afcaff/opamp-amp/docs/HandCalcs.pdf

Adrian Franco Preamp calculations: Gain stage
Gain:
GG = 1 +

RRFF
RRGG
1 +

100kk
10kk = 11
Gain(dB):
GG = 20 log 11
20 log 11 = 20.8 dddd
Frequency of High pass corner (gain stage): ff(HHHH) = 1
2ππ ππ
1
2ππ × 10kk × 1nnnn = 1.59 HHHH Frequency of Low pass corner (gain stage): ff(HHHH) = 1
2ππ ππ
1
2ππ × 10kk × 47μμ

= 0.338 HHHH
Active Baxandall circuit
Bass side resistors ( Rpot = 100k)
GG = RR2
RR1
(100kk + RR)
RR = 4
4RR = 100kk + RR
RR = 100kk
3
RR ≈ 33kk

Capacitor values for low corner (bass), target 50 Hz: ff = 1
2ππ ππ
= 1
2ππ
= 1
2ππ × 33kk × 50
= 31.8nnnn → 33nnnn
Bass Gain range:
GG = 100kk + 33kk
33kk
GG ≈ 4
GG = 20 log(4) = 12dddd
GG = 33kk
(100kk + 33kk)
GG = 0.248
GG = 20 log 0.248
GG = −12dddd
GG = ±12dddd
Treble side resistor:
1 +

33kk
RR = 4
3 =

33kk
RR
RR = 11kk
Capacitor (target 3k Hz)
= 1
2ππ × 11kk × 3kk
= 4.82nnnn → 4.7nnnn

Treble gain range:
GG = 1 +

33kk
11kk = 4
GG = 20 log 4 = 12dddd

GG =

1
33kk
1

33kk + 1
11kk
GG ≈ 0.25
GG = 2 log 0.25 = −12dddd
GG = ±12dddd
