afcaff/opamp-amp/FullCircuitsim/ac-flat.pdf

(A) FLATAC.dat

Frequency

10Hz | 100Hz | 1.0KHz | 10KHz | 100KHz
DB(V(U2:5)/V(V1:+))

0

5

10

15

20

25

30
