afcaff/opamp-amp/media/complete.jpg

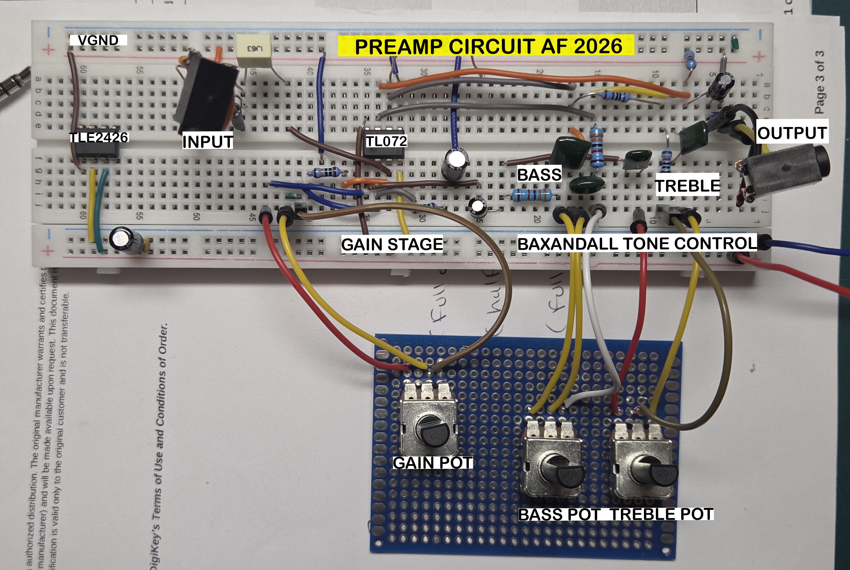
media/complete.jpg
