afcaff/opamp-amp/media/gbr.png

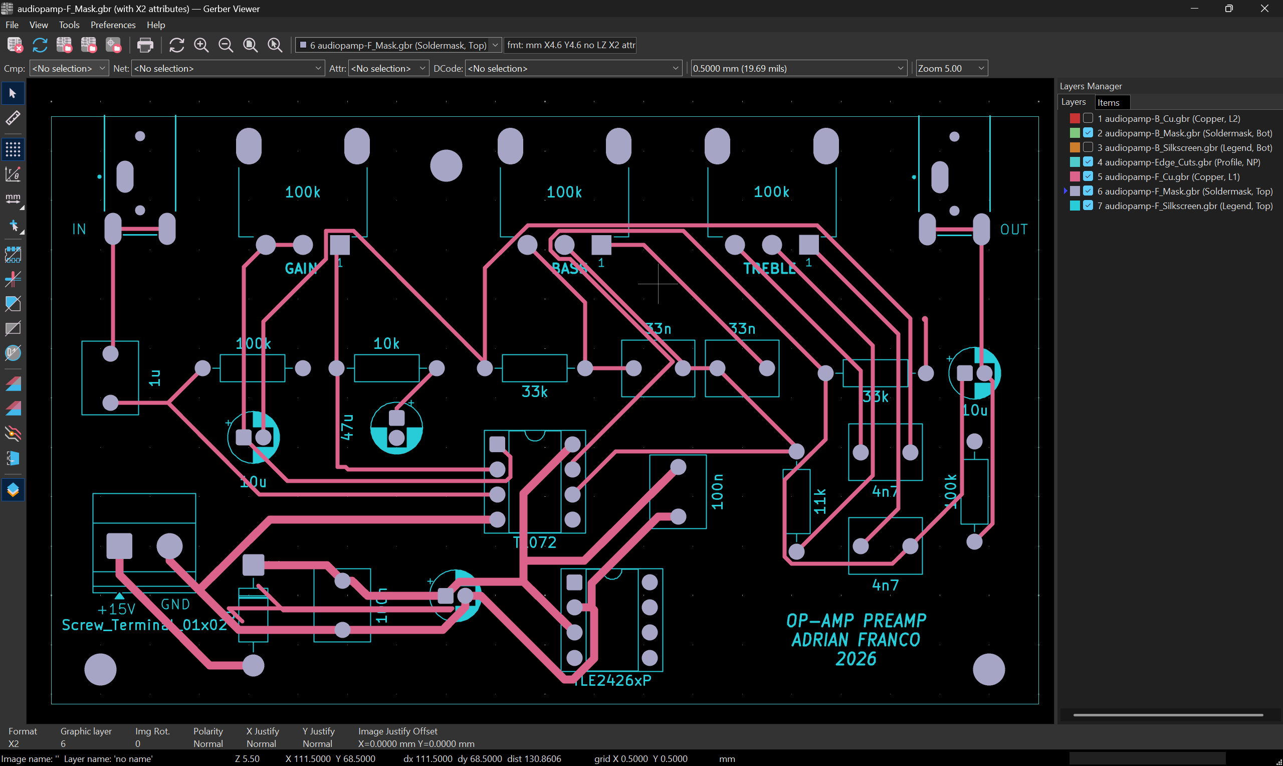
media/gbr.png
