afcaff/opamp-amp/media/scope/dso_01_01_01_24_35.bmp

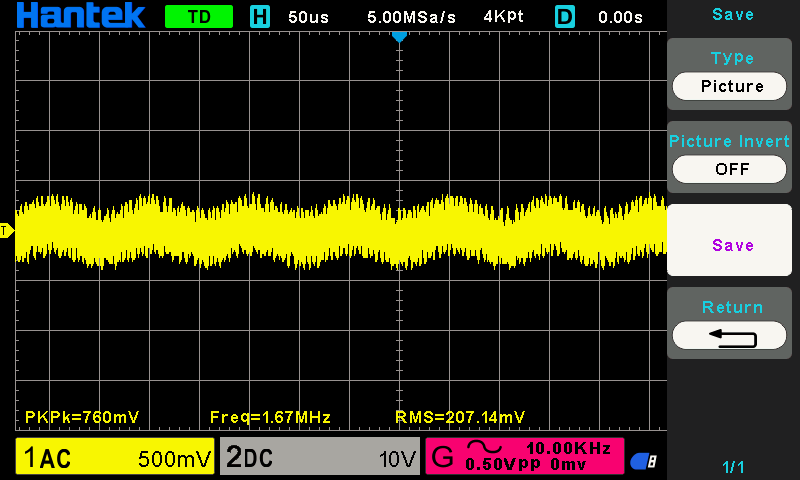
media/scope/dso_01_01_01_24_35.bmp
