afcaff/opamp-amp/media/scope/gain.bmp

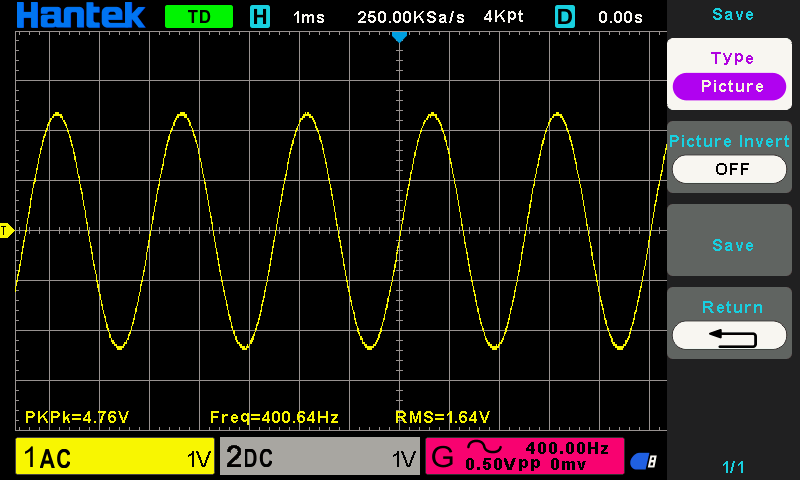
media/scope/gain.bmp
