afcaff/opamp-amp/media/scope/trebboost.bmp

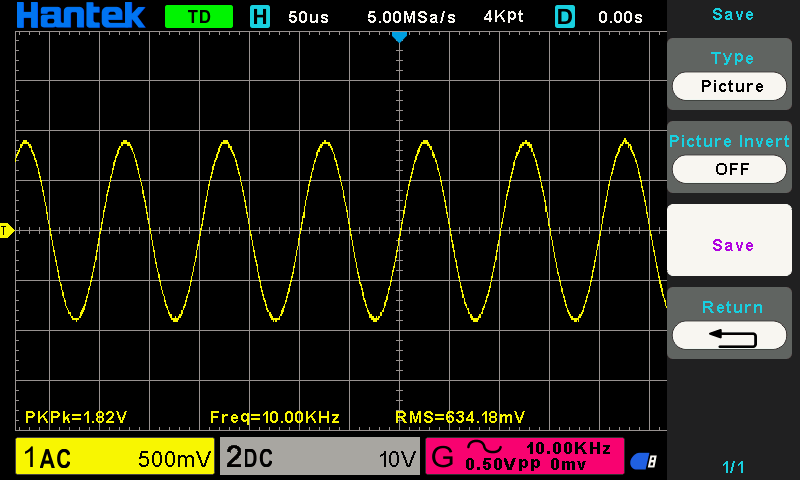
media/scope/trebboost.bmp
