afcaff/opamp-amp/media/scope/trebscratch.bmp

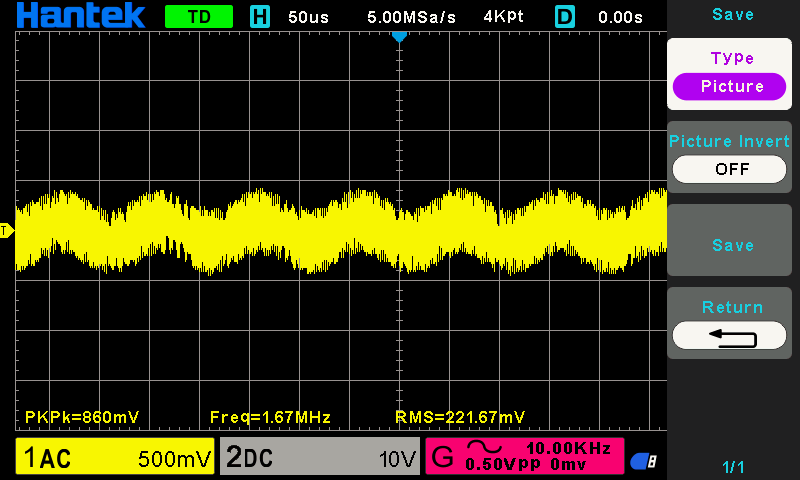
media/scope/trebscratch.bmp
