afcaff/opamp-amp/sim/baxandall/activebaxandall.png

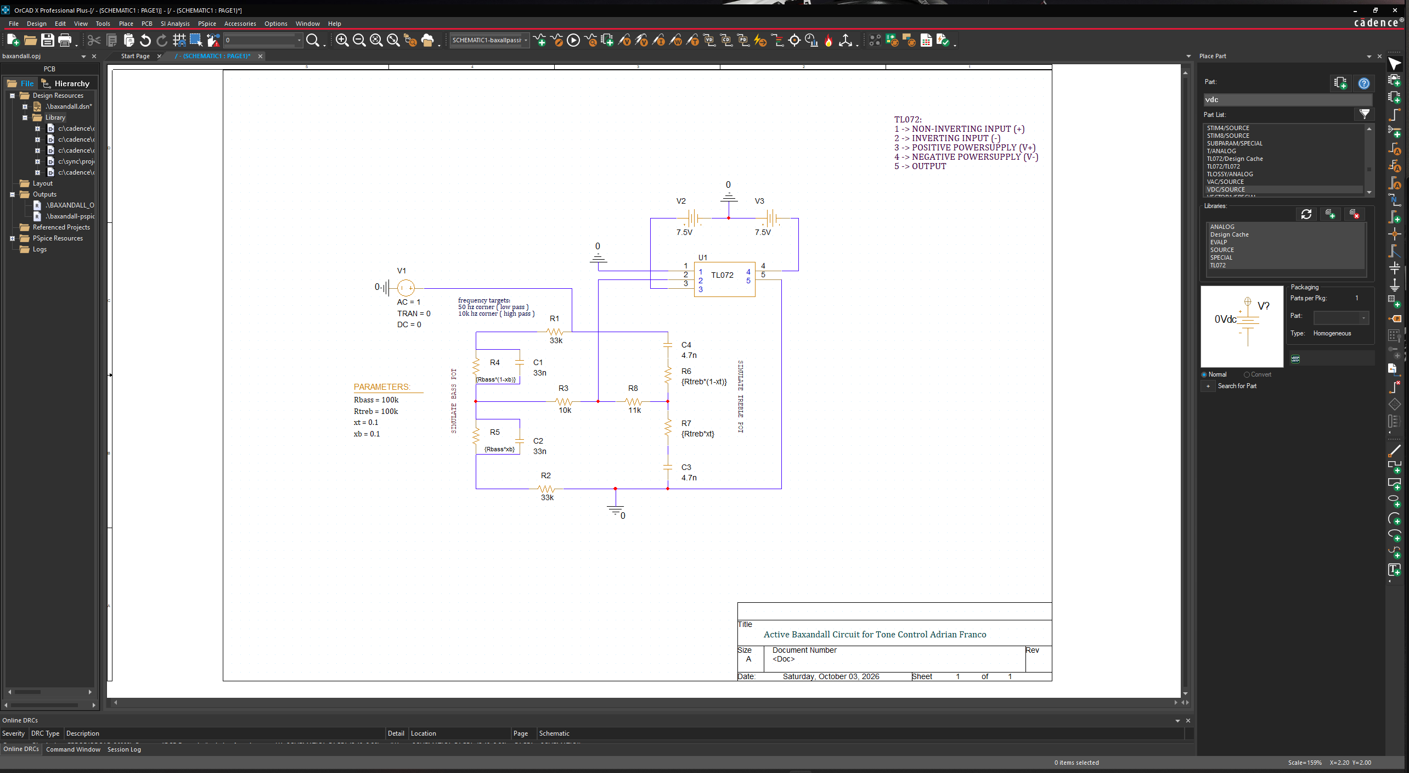
sim/baxandall/activebaxandall.png
