afcaff/opamp-amp/sim/baxandall/ActiveBaxandall/0dBSymmetry.png

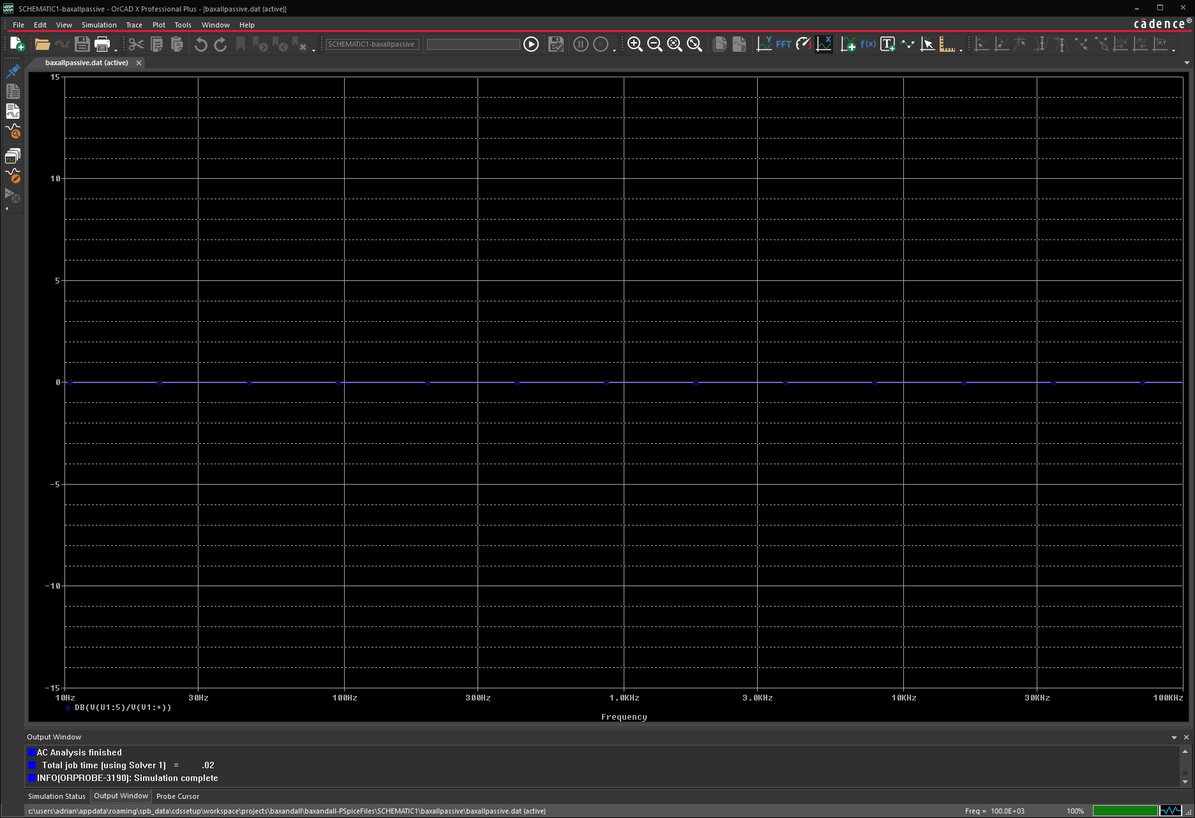
sim/baxandall/ActiveBaxandall/0dBSymmetry.png
