afcaff/opamp-amp/sim/baxandall/ActiveBaxandall/12dBRange-Treble.png

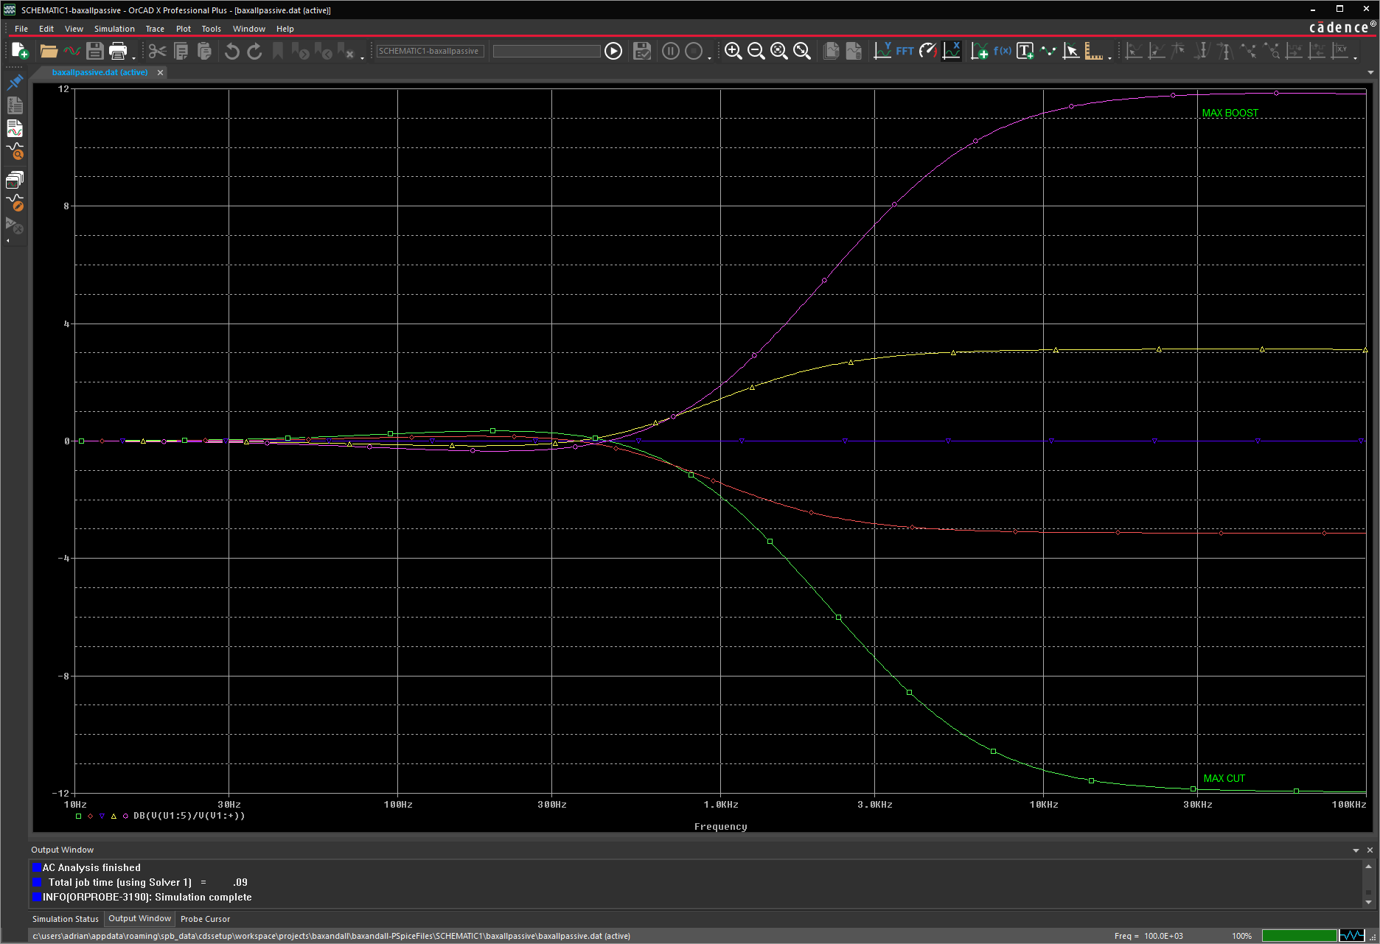
sim/baxandall/ActiveBaxandall/12dBRange-Treble.png
