afcaff/opamp-amp/sim/baxandall/activeBaxandallCricuitreference.png

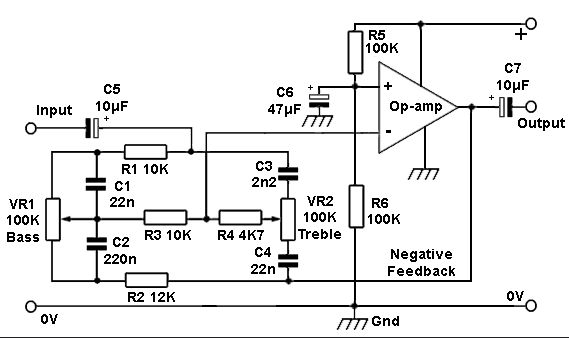
sim/baxandall/activeBaxandallCricuitreference.png
