afcaff/opamp-amp/sim/baxandall/baxandallresponse.jpg

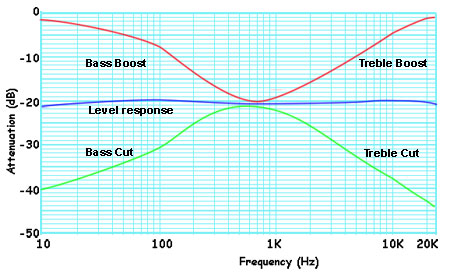
sim/baxandall/baxandallresponse.jpg
