afcaff/opamp-amp/sim/baxandall/passiveBxdall/bxdall.png

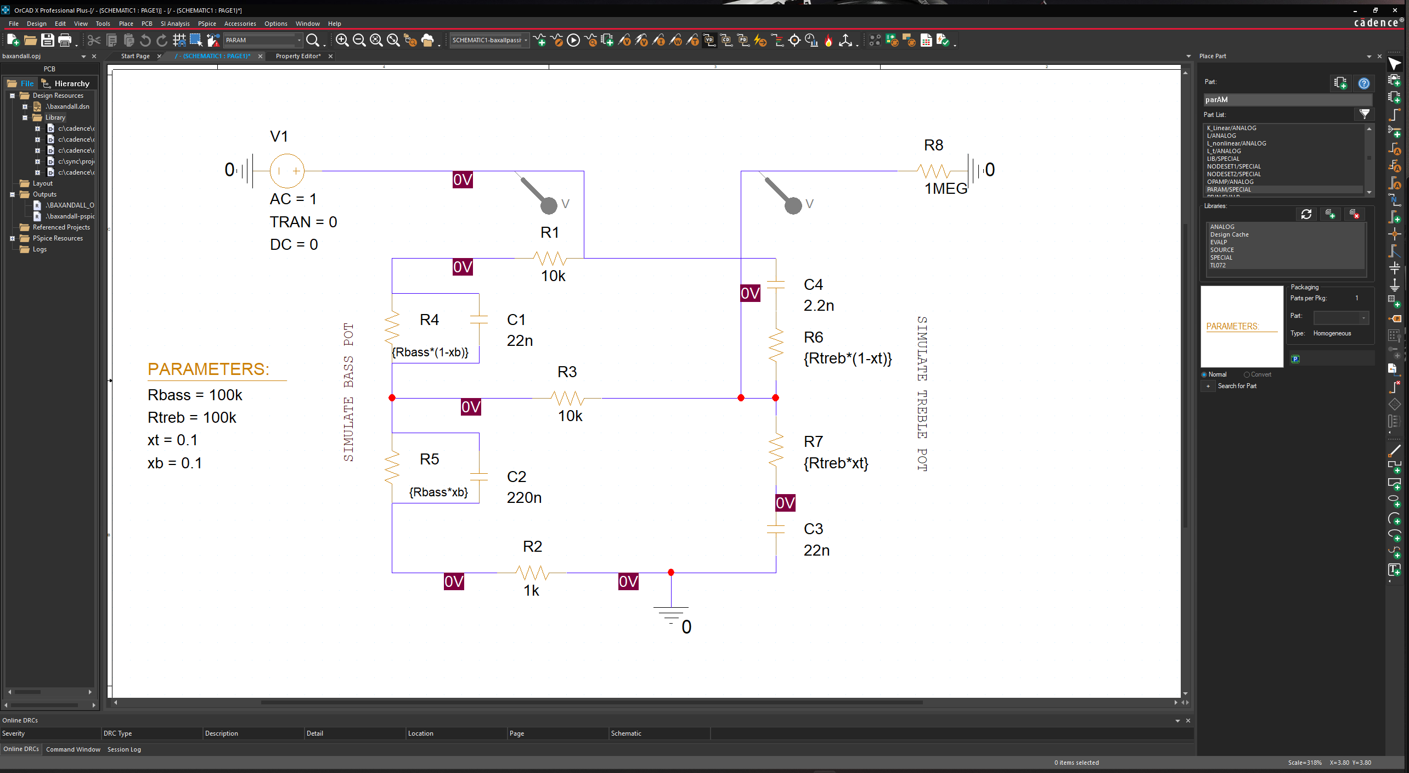
sim/baxandall/passiveBxdall/bxdall.png
