afcaff/opamp-amp/sim/baxandall/passiveBxdall/TREBmaxboostmaxcut.png

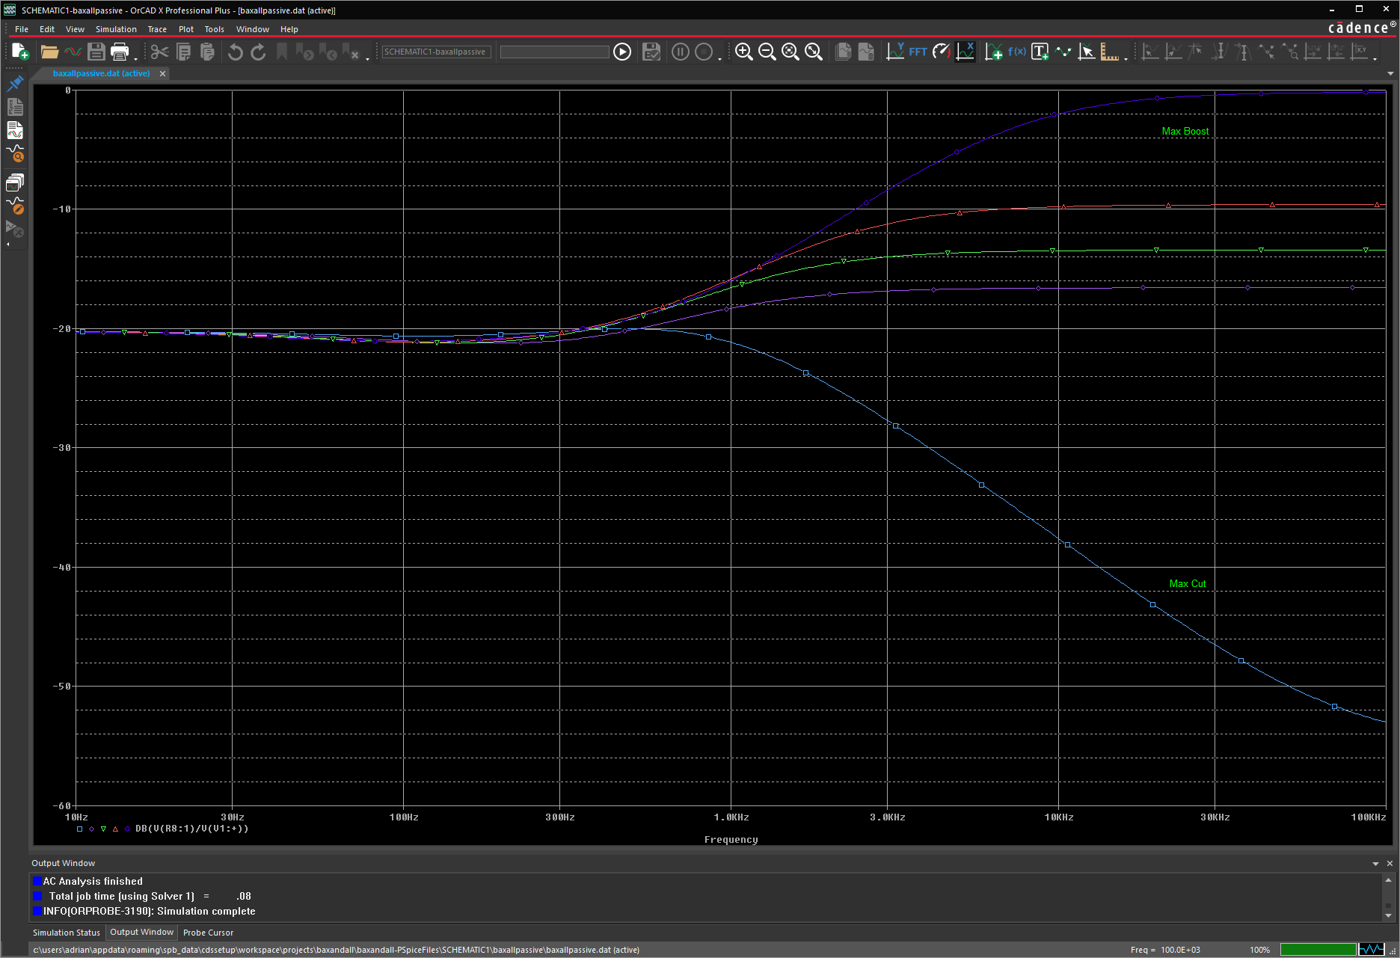
sim/baxandall/passiveBxdall/TREBmaxboostmaxcut.png
