afcaff/opamp-amp/sim/GainStage/fftHarmonics.png

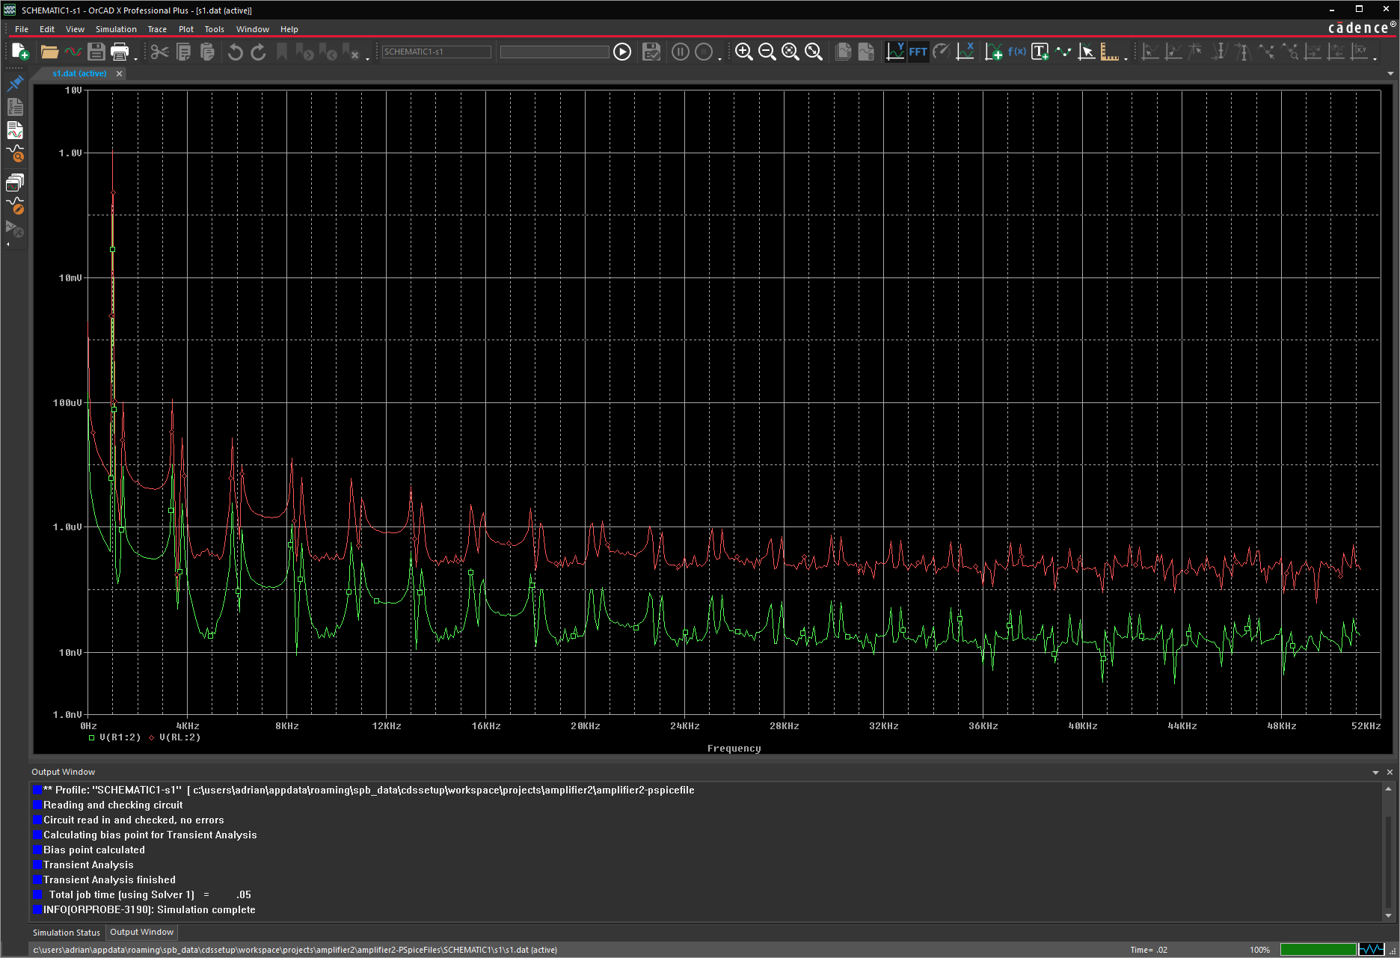
sim/GainStage/fftHarmonics.png
