afcaff/opamp-amp/sim/GainStage/GainCircuit.png

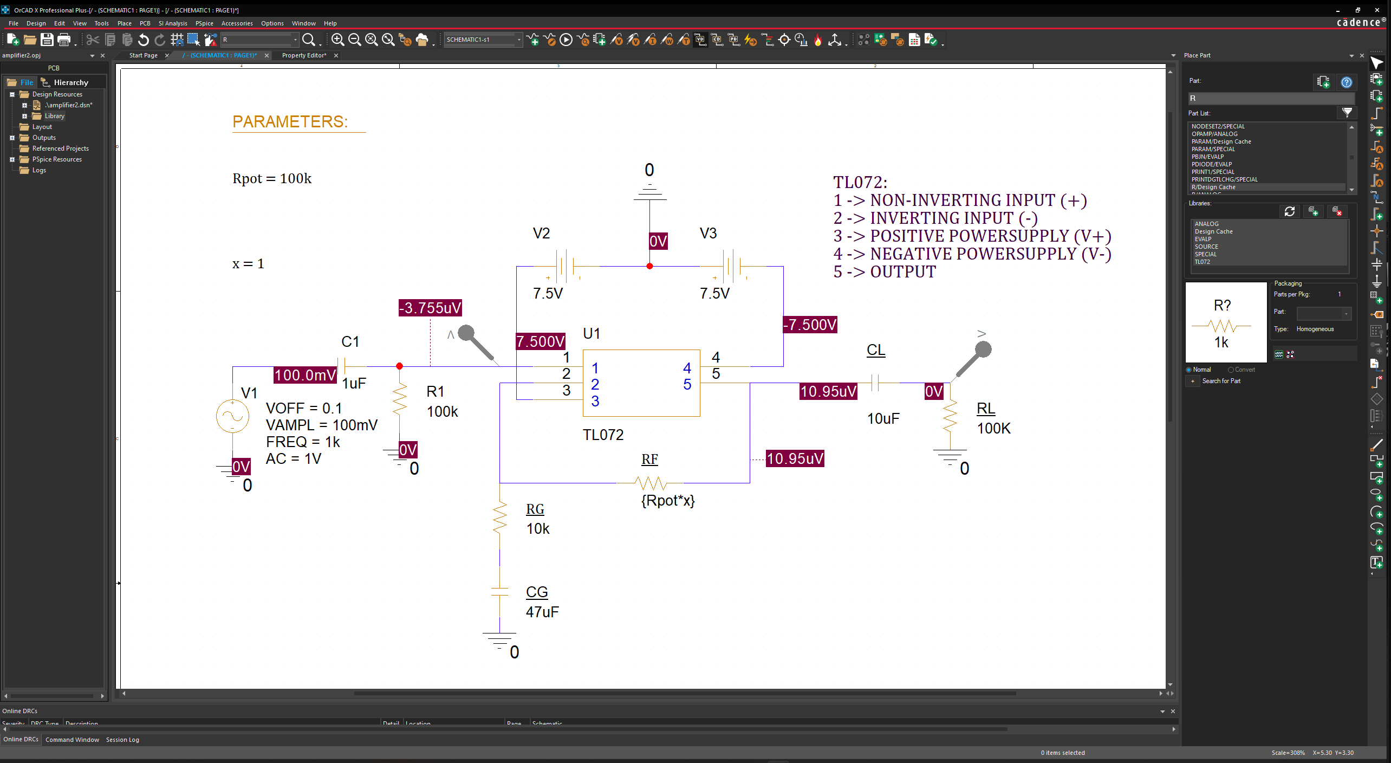
sim/GainStage/GainCircuit.png
