afcaff/opamp-amp/sim/GainStage/SweepdB.png

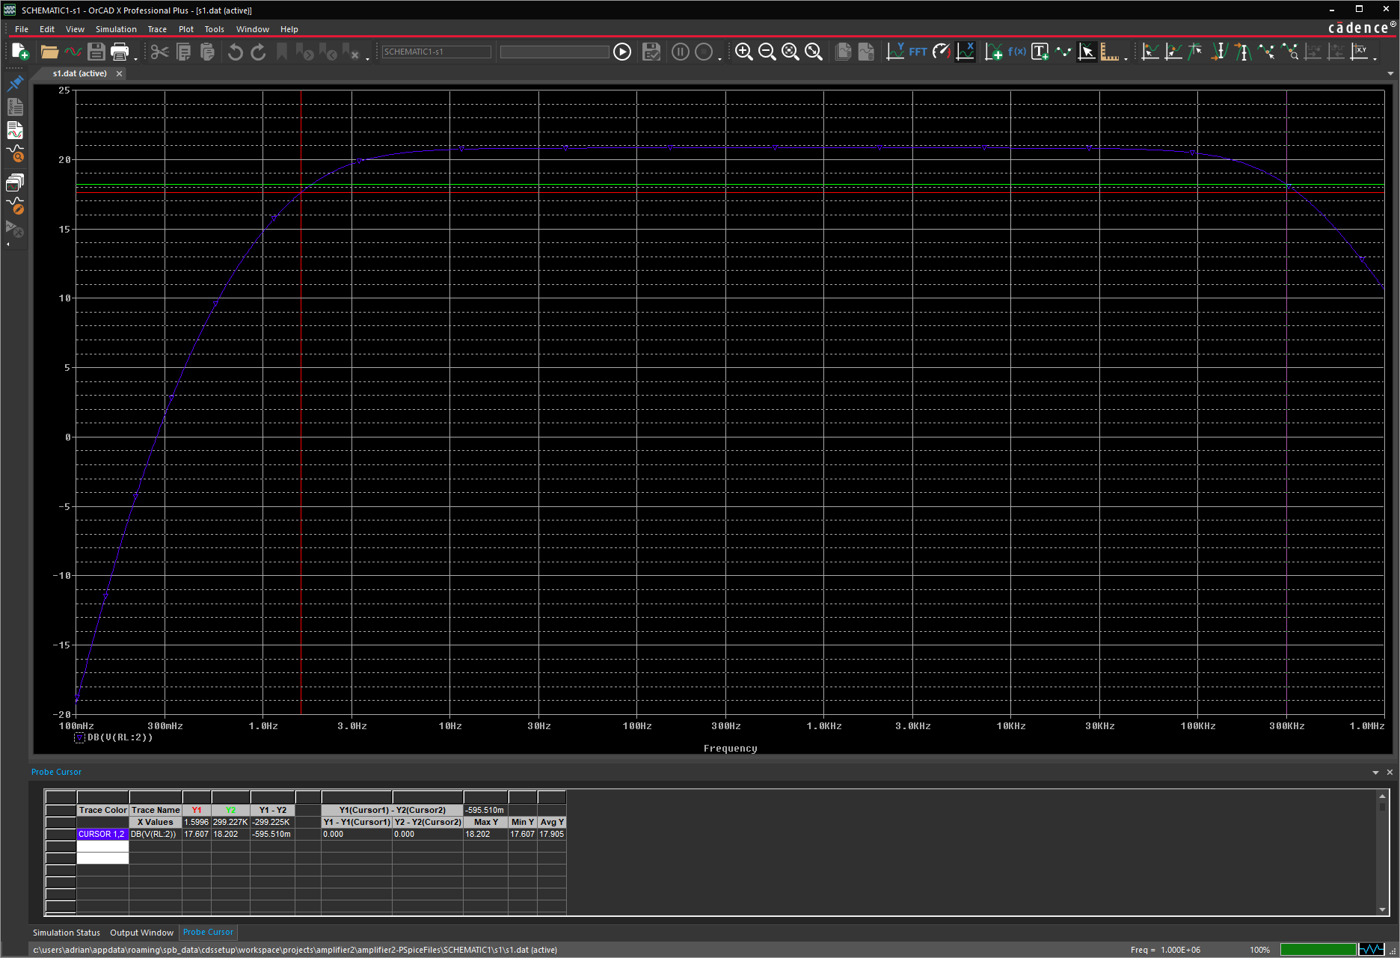
sim/GainStage/SweepdB.png
