afcaff/opamp-amp/sim/non-inverting/circuit.png

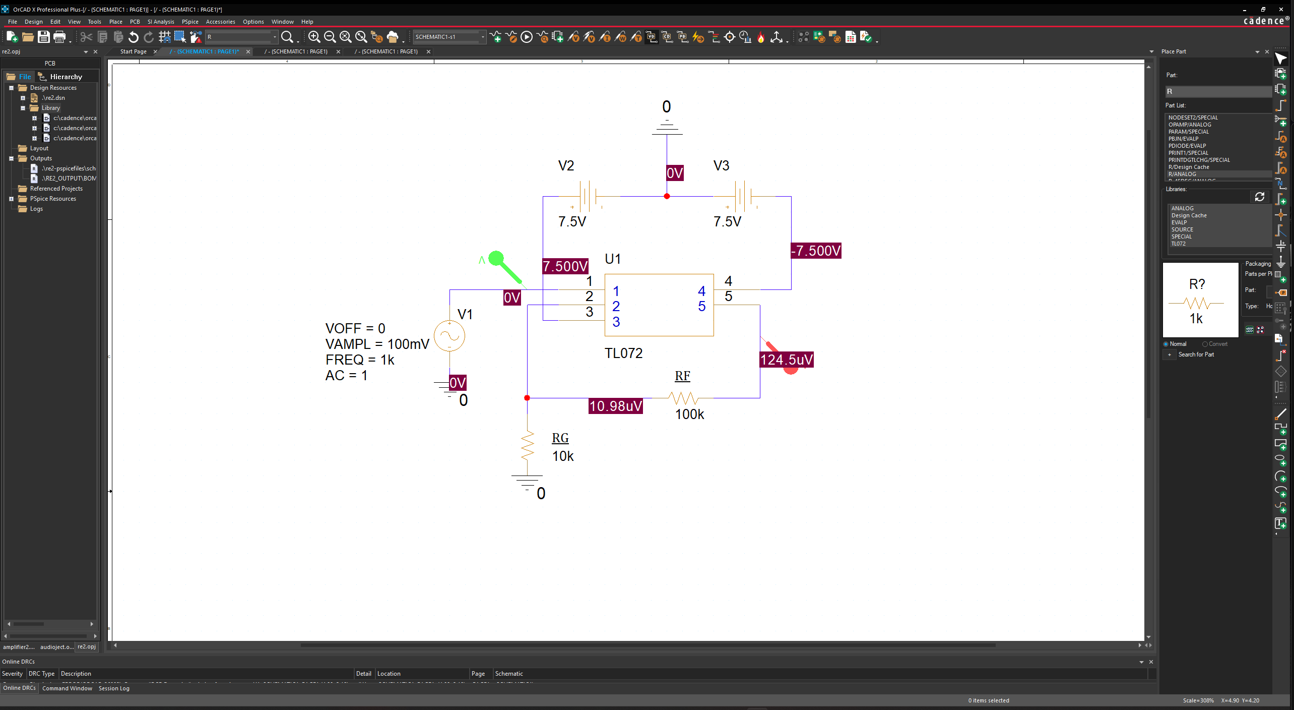
sim/non-inverting/circuit.png
