afcaff/opamp-amp/sim/non-inverting/clipping1V.png

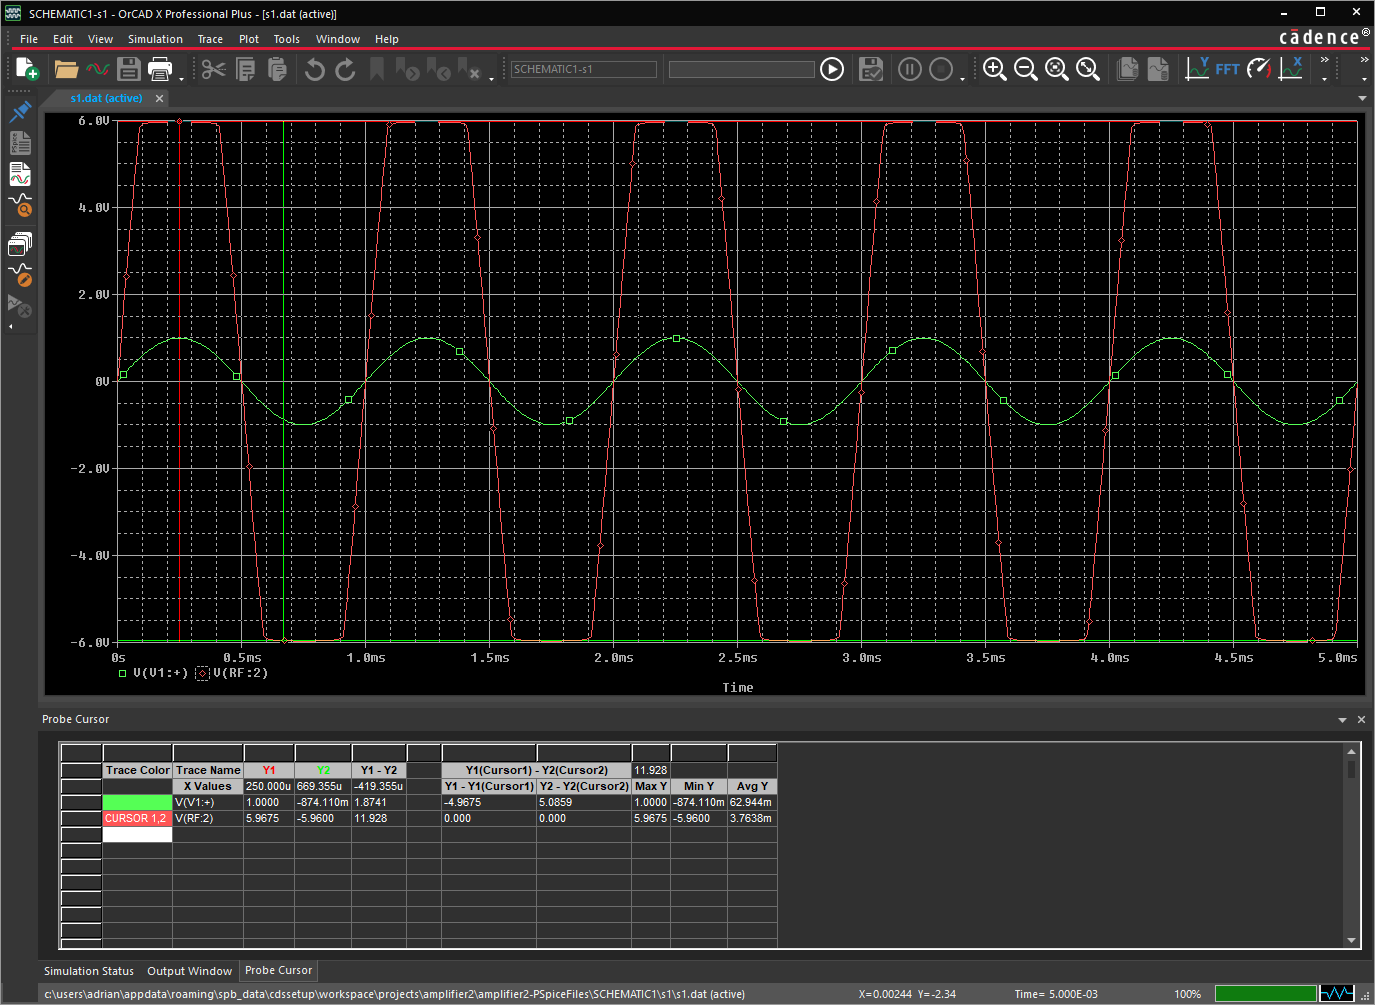
sim/non-inverting/clipping1V.png
