afcaff/opamp-amp/sim/non-inverting/clipping10V.png

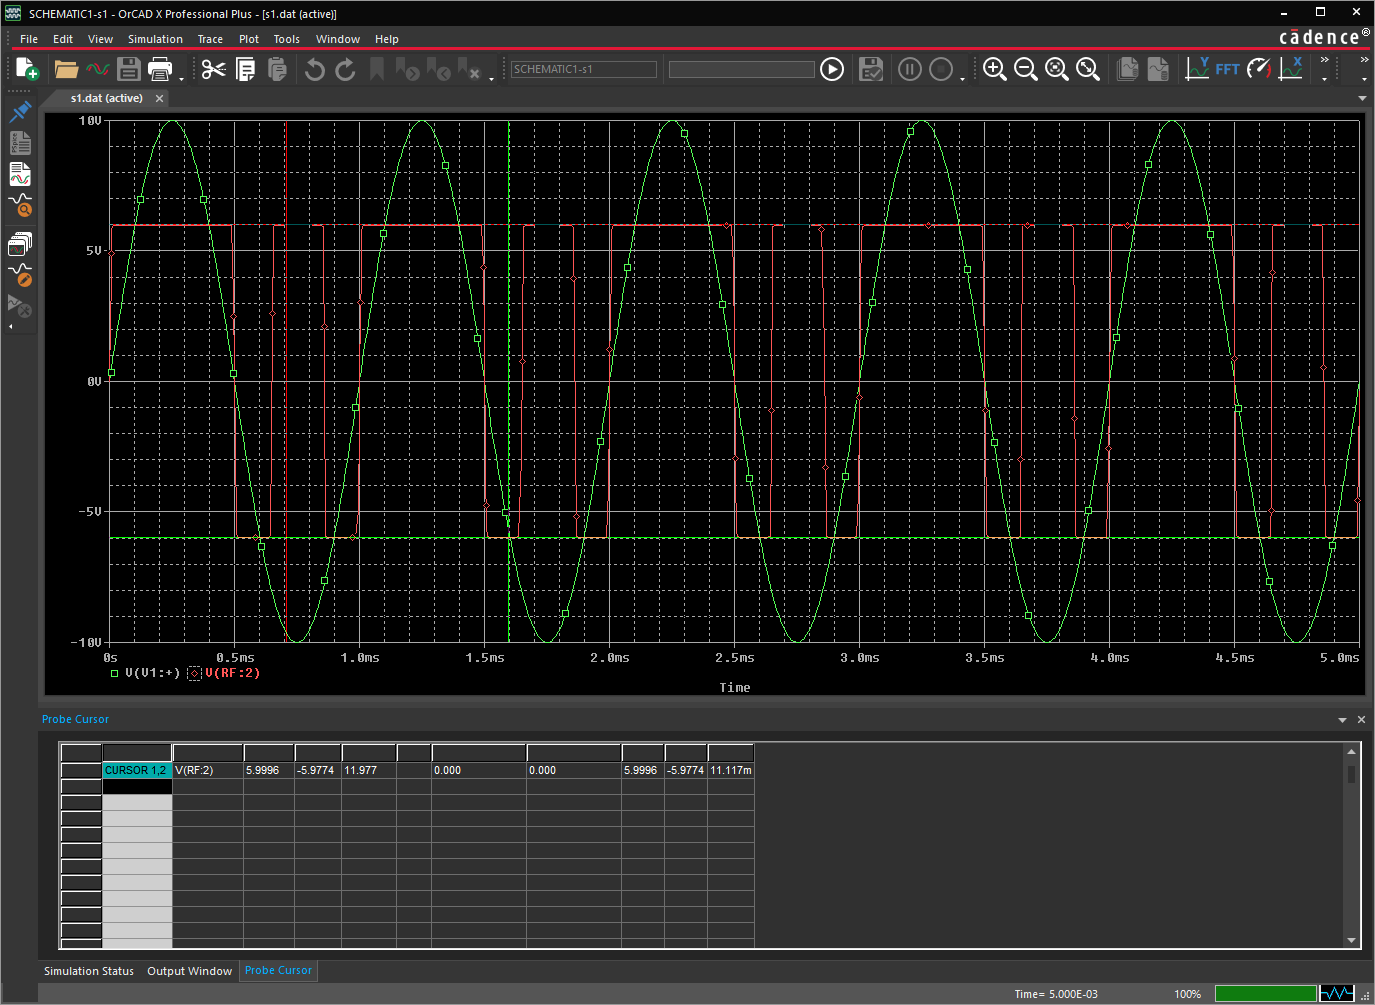
sim/non-inverting/clipping10V.png
