afcaff/opamp-amp/sim/non-inverting/transient.png

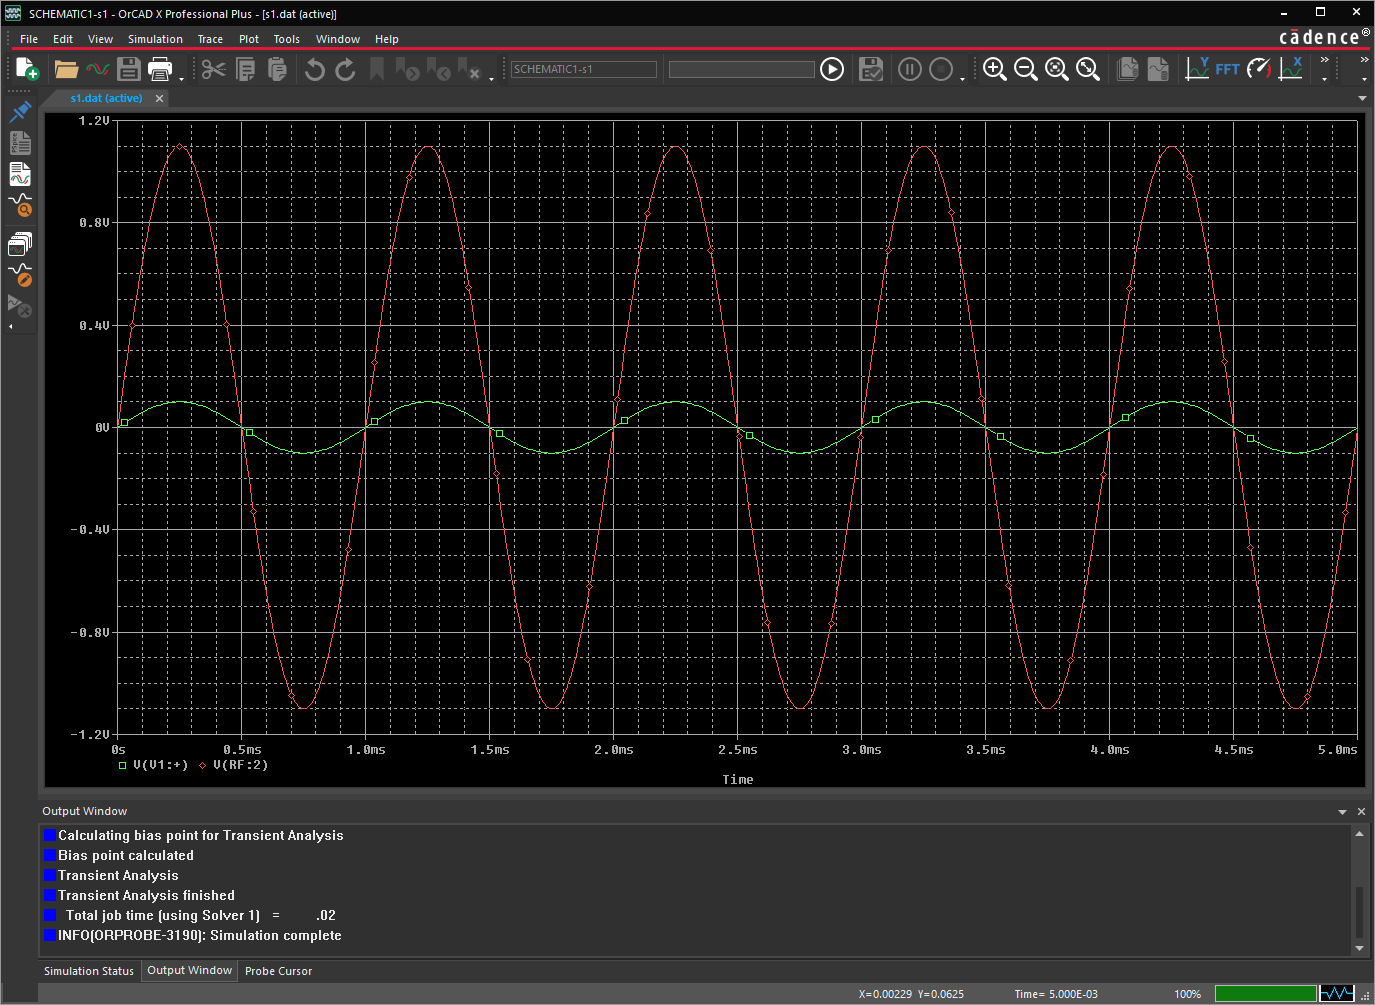
sim/non-inverting/transient.png
