afcaff/opamp-amp/sim/non-invertingWpot/circuit.png

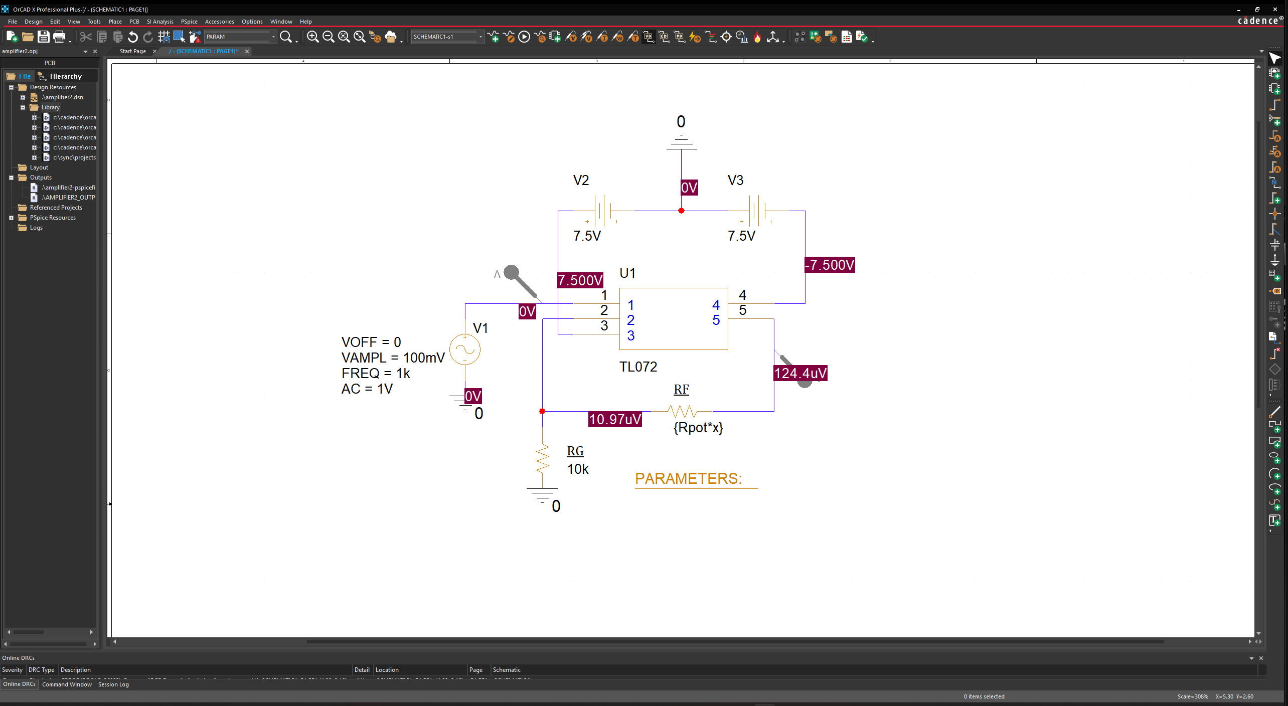
sim/non-invertingWpot/circuit.png
