afcaff/opamp-amp/sim/non-invertingWpot/SweepdB.png

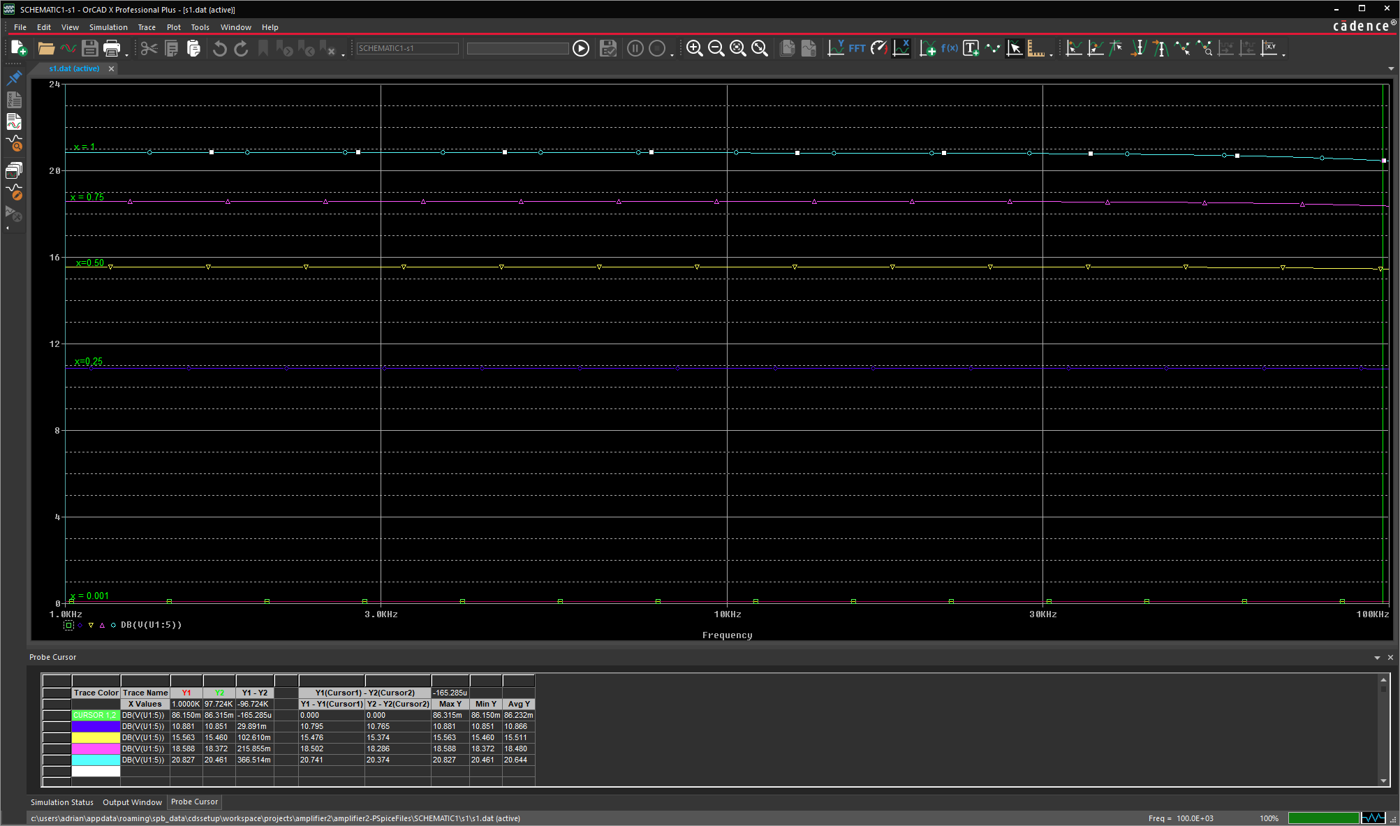
sim/non-invertingWpot/SweepdB.png
