afcaff/opamp-amp/media/pcbassemble.jpg

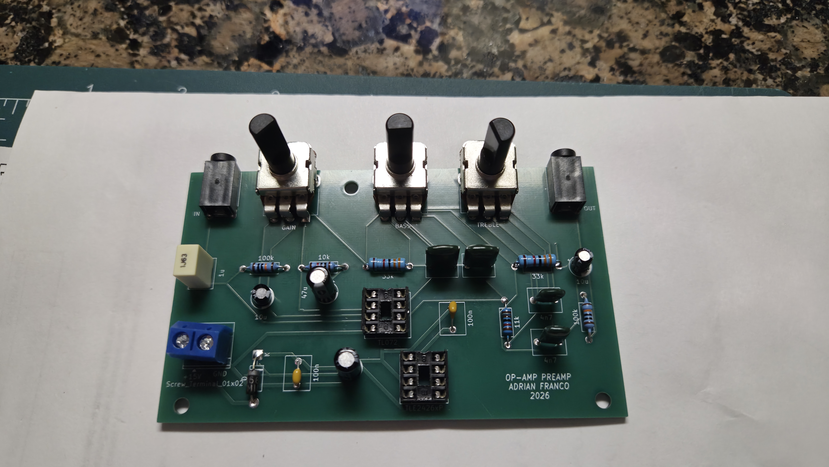
media/pcbassemble.jpg
