afcaff/opamp-amp/measure/scope/bassboost.bmp

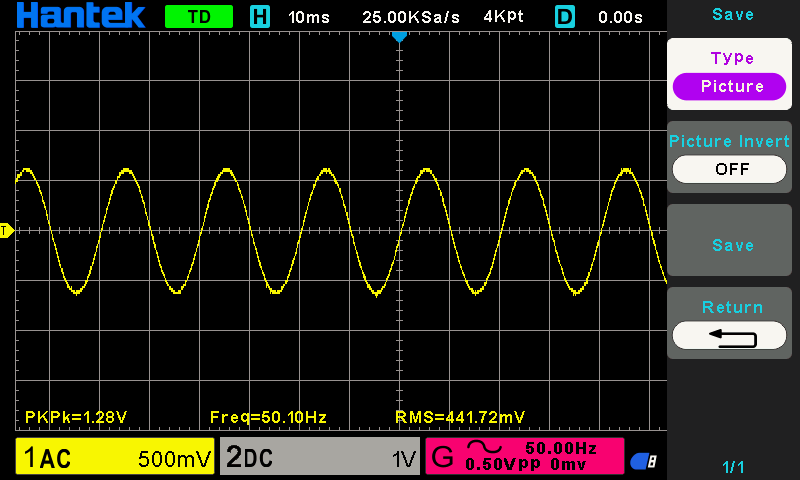
measure/scope/bassboost.bmp
