afcaff/opamp-amp/measure/scope/basscut.bmp

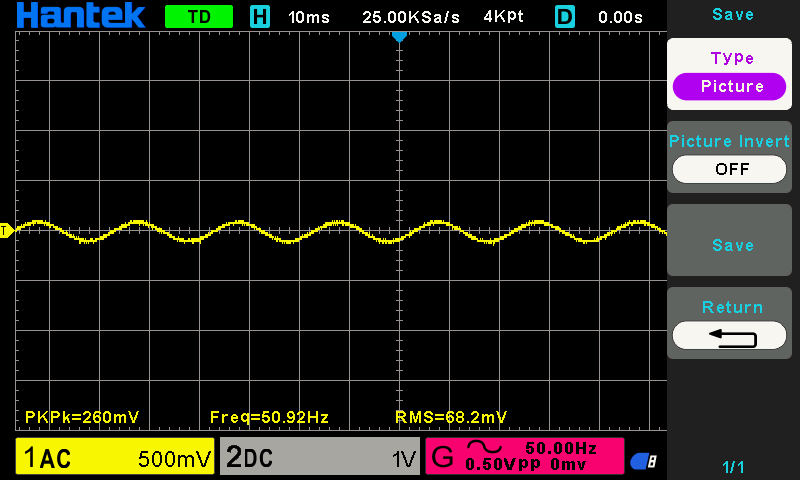
measure/scope/basscut.bmp
