afcaff/opamp-amp/measure/scope/basscut.jpg

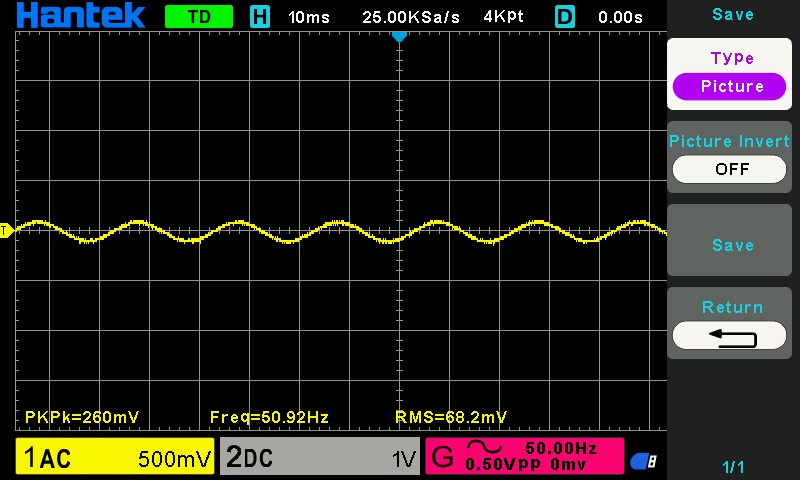
measure/scope/basscut.jpg
