afcaff/opamp-amp/measure/scope/bassmid.jpg

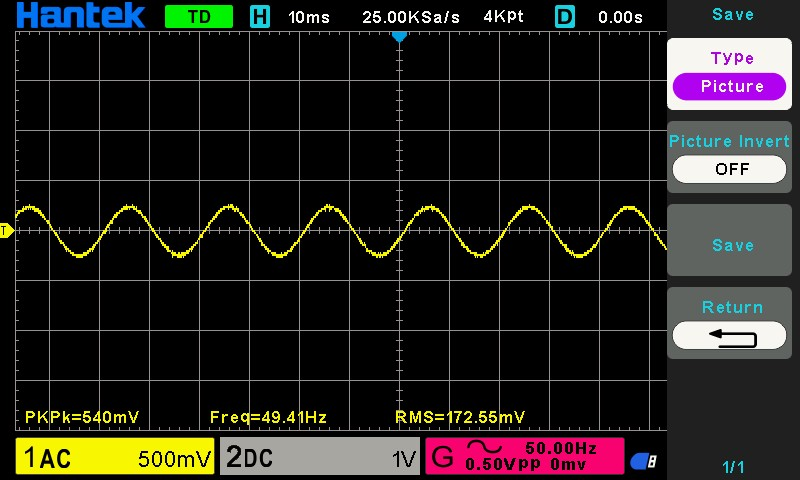
measure/scope/bassmid.jpg
