afcaff/opamp-amp/measure/scope/trebbcutb4break.bmp

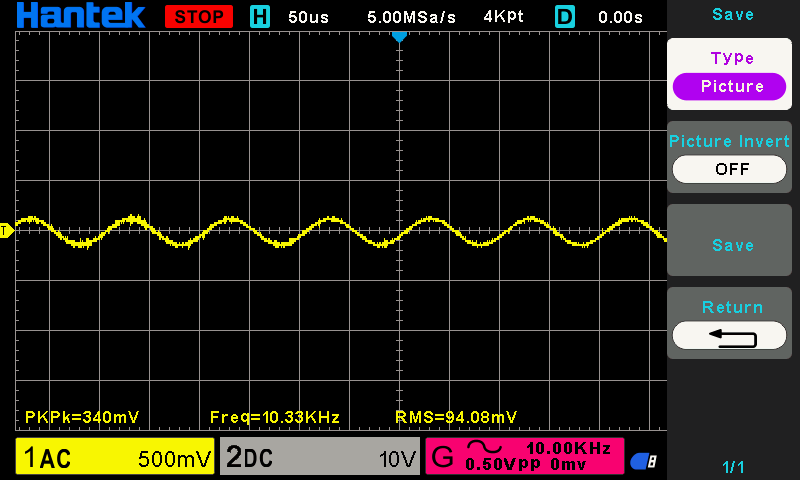
measure/scope/trebbcutb4break.bmp
