afcaff/opamp-amp/measure/scope/trebmid.bmp

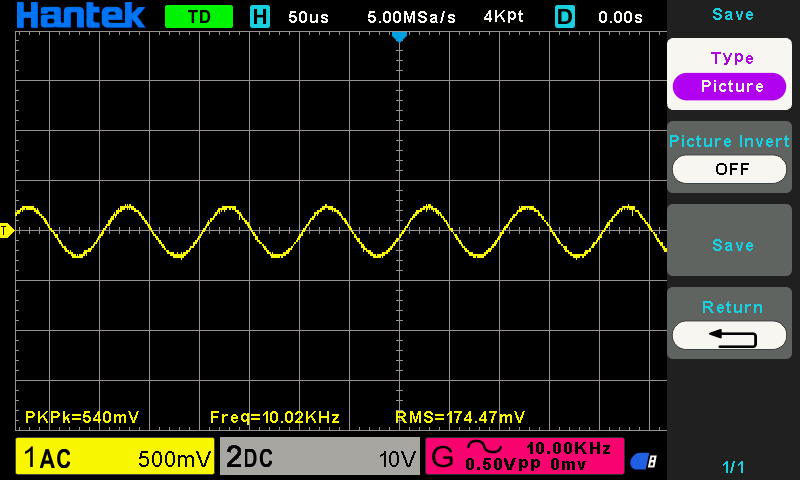
measure/scope/trebmid.bmp
