afcaff/opamp-amp/measure/scope/trebmid.jpg

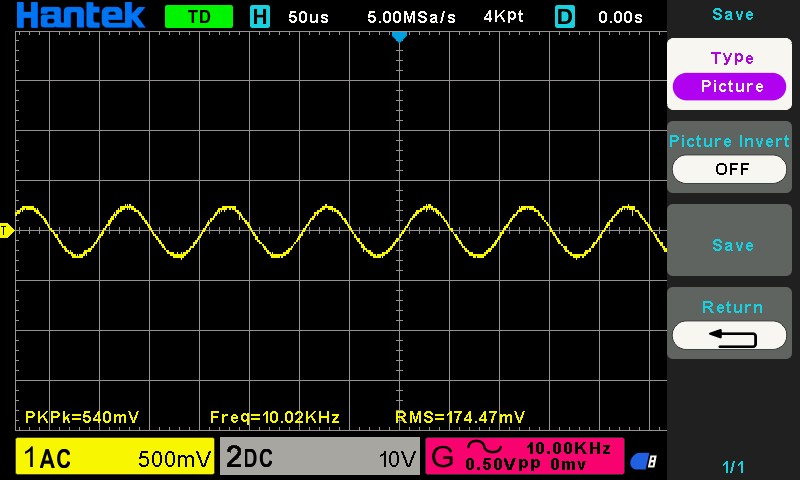
measure/scope/trebmid.jpg
