afcaff/opamp-amp/sim/buff_test/capture.png

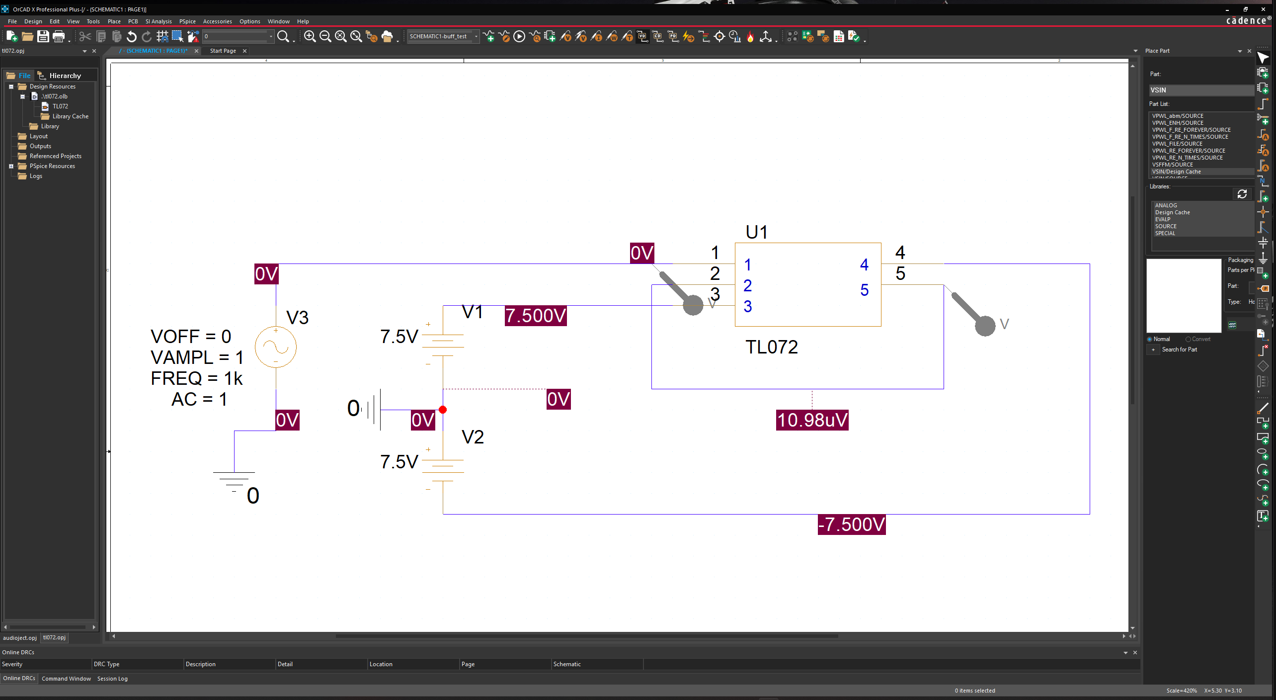
sim/buff_test/capture.png
