afcaff/opamp-amp/sim/buff_test/pspice.png

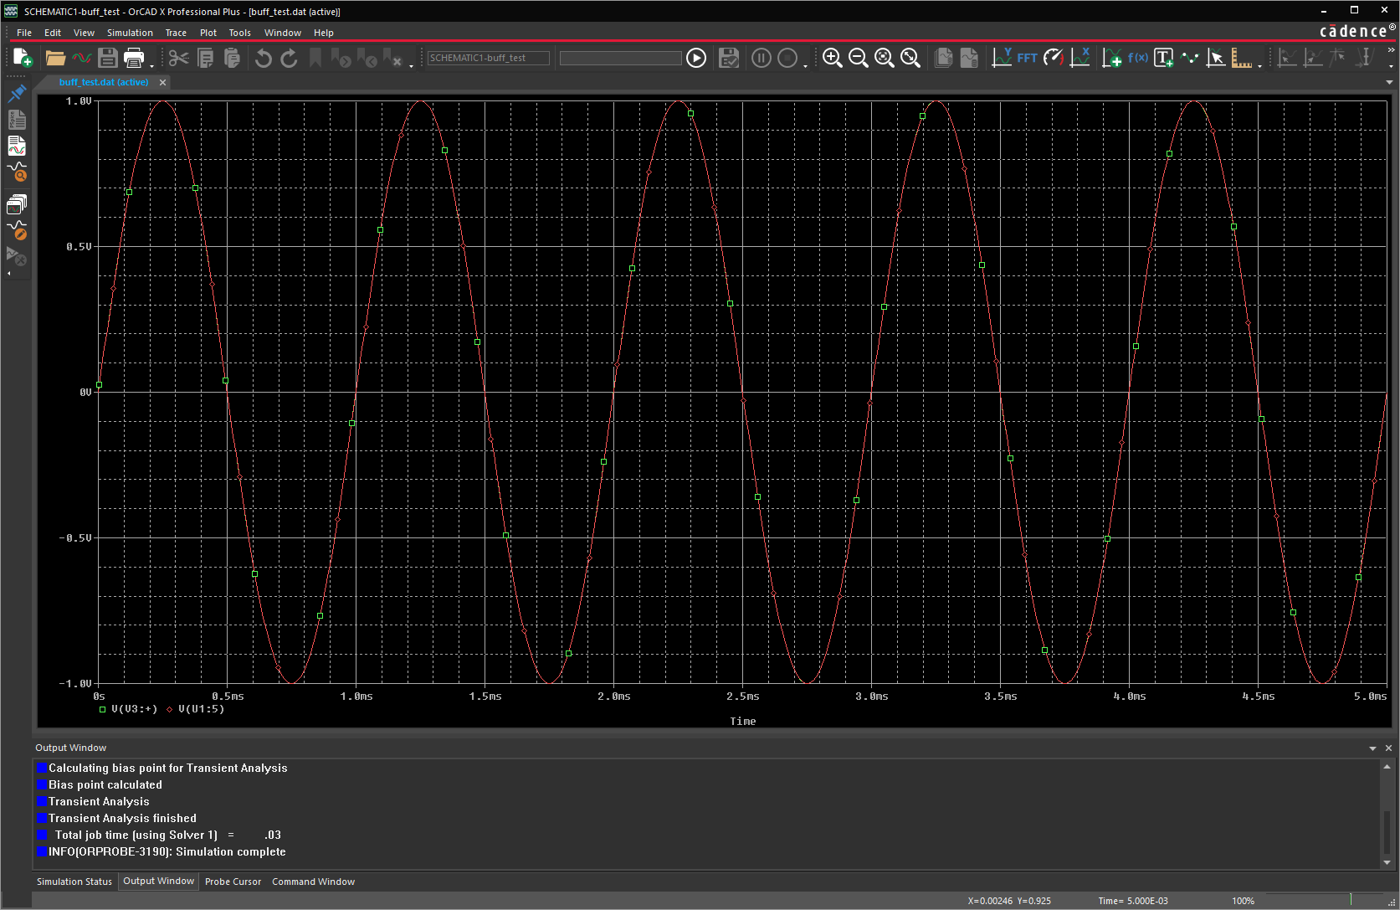
sim/buff_test/pspice.png
