afcaff/opamp-amp/FullCircuitsim/ac-treble.pdf

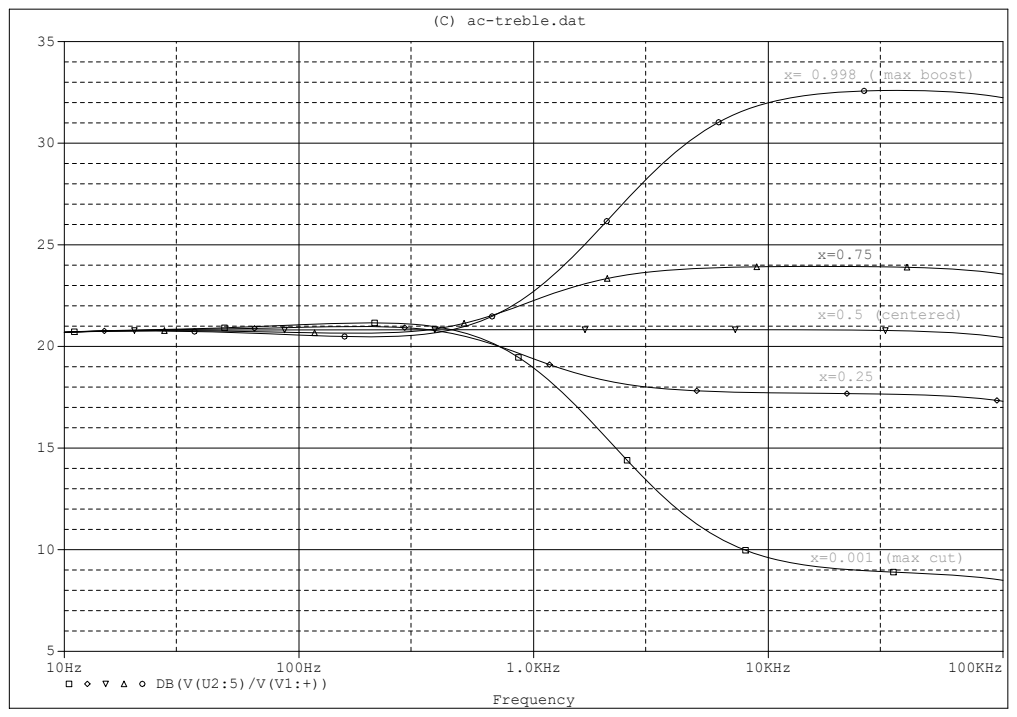
[picture p37: page 1]
Frequency; 1.0KHz; 10KHz; 100KHz; max boost); x=0.5 (centered); (max cut)

(C) ac-treble.dat
