afcaff/opamp-amp/FullCircuitsim/ac_bass.pdf

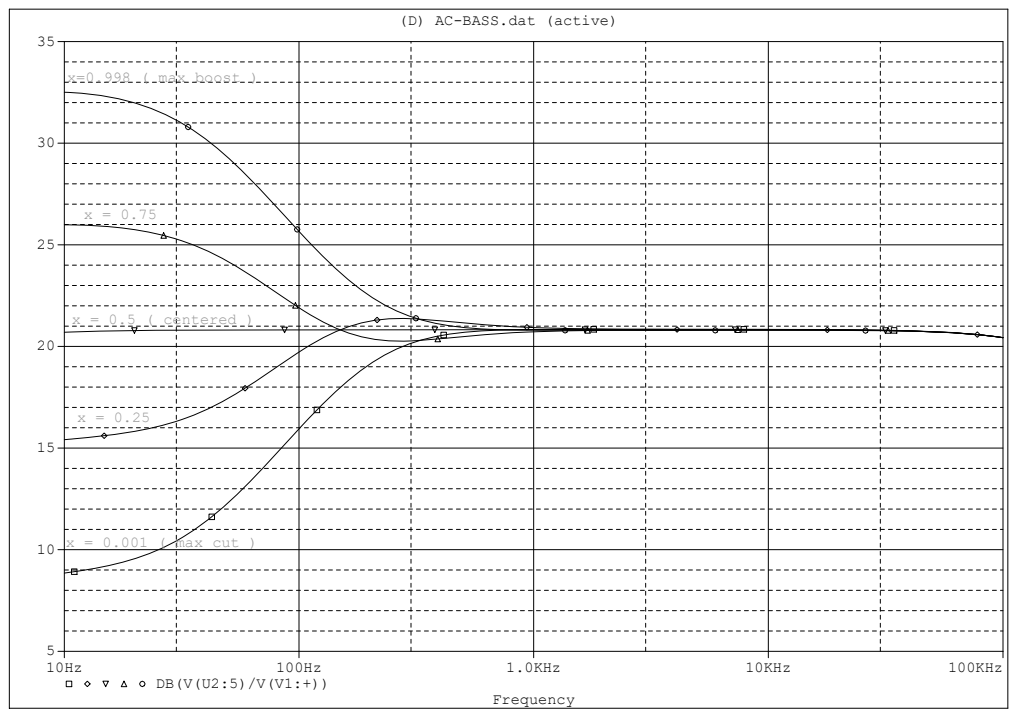
[picture p38: page 1]
Frequency; 1.0KHz; 10KHz; 100KHz; max cut ); x = 0.5 ( centered ); x=0.998 ( max boost )

(D) AC-BASS.dat (active)
