afcaff/opamp-amp/FullCircuitsim/PreAmpAF.pdf

0

0

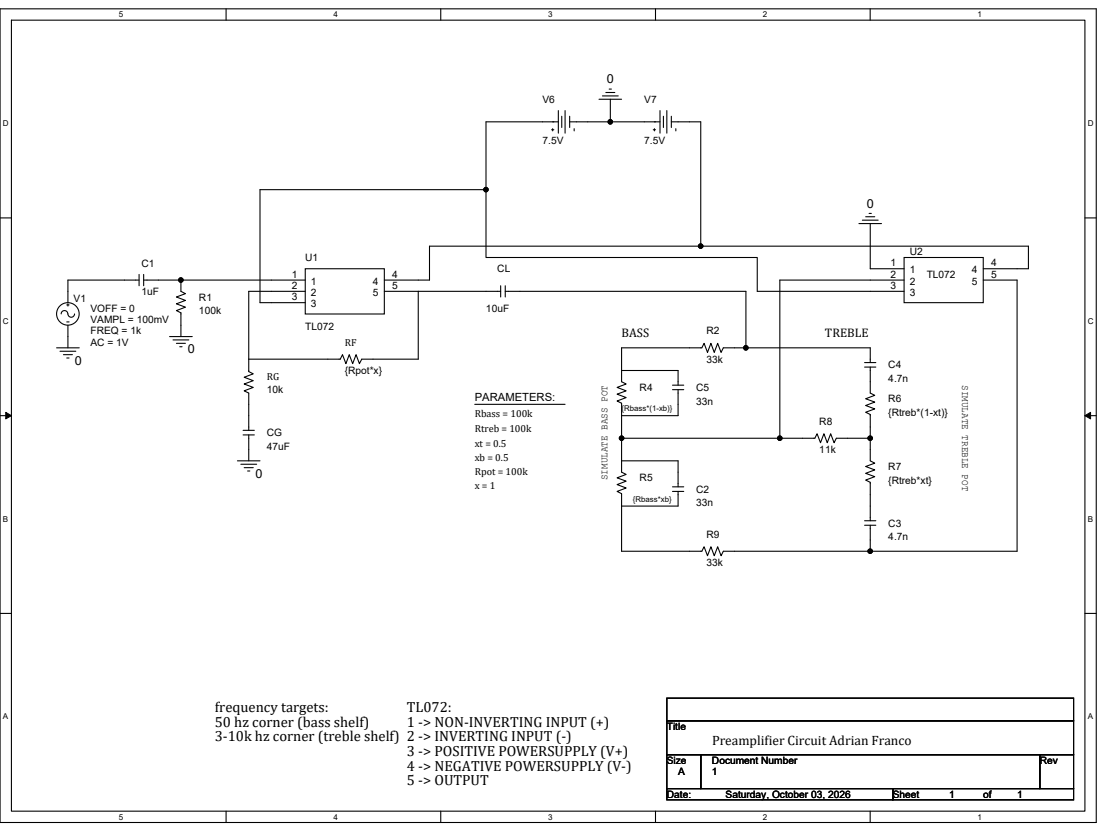
[picture p39: page 1]

frequency targets:
50 hz corner (bass shelf)
3-10k hz corner (treble shelf)

Title
Preamplifier Circuit Adrian Franco

Size Size Size A A A | Document Number Document Number Document Number 1 1 1 | Rev Rev Rev

Date: Date: Date: Saturday, October 03, 2026 Saturday, October 03, 2026 Saturday, October 03, 2026 | Sheet Sheet Sheet 1 1 1 of of of 1 1 1
