afcaff/opamp-amp/docs/PrintUSchematic.pdf

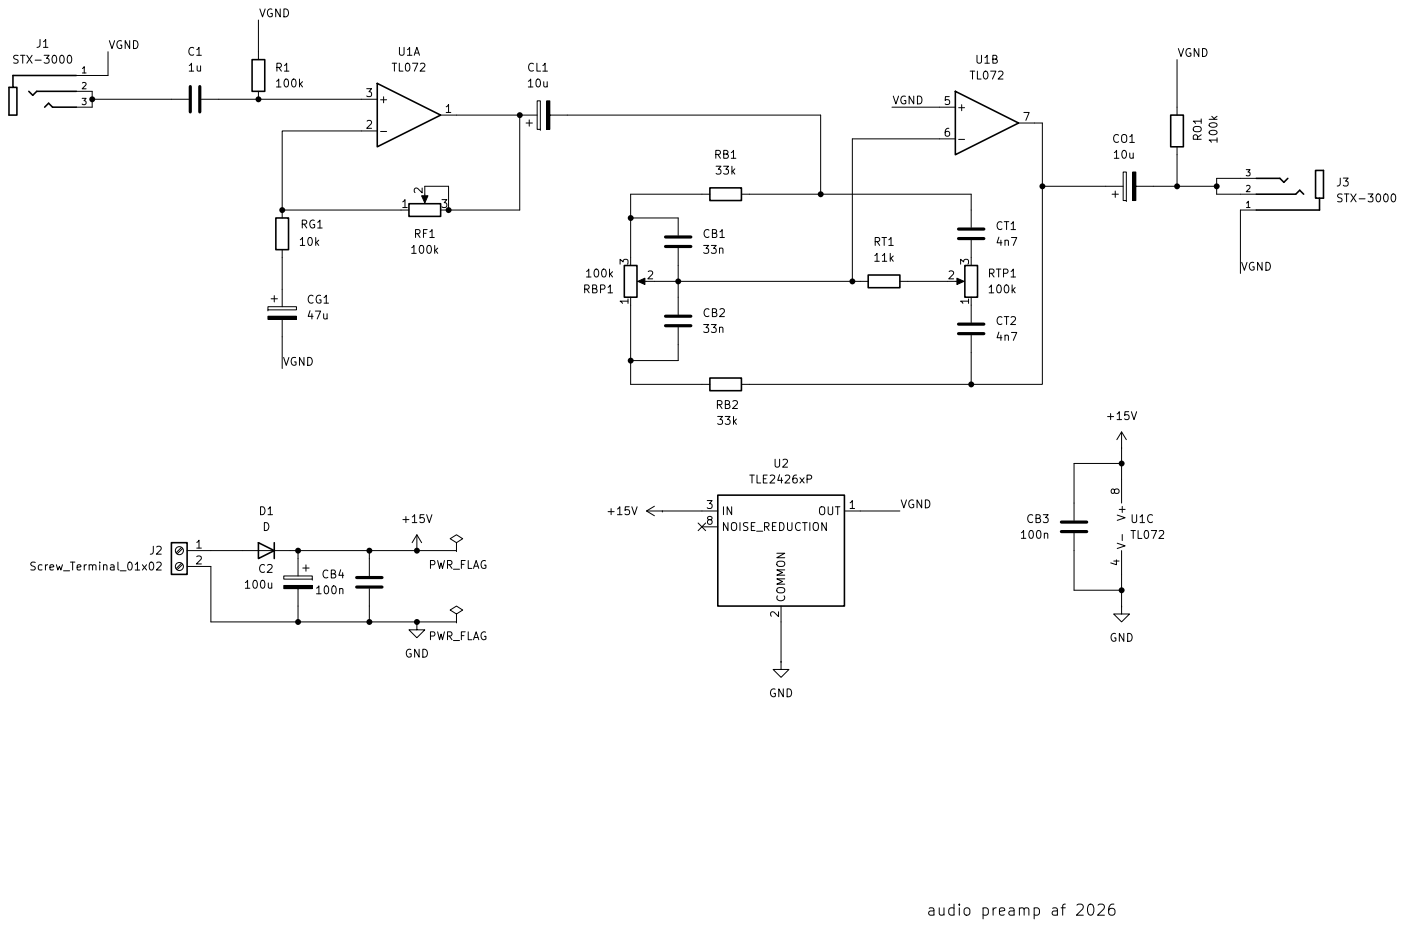
[picture p40: page 1]
