afcaff/opamp-amp/FullCircuitsim/transient.pdf

## (A) Transient.dat (active)

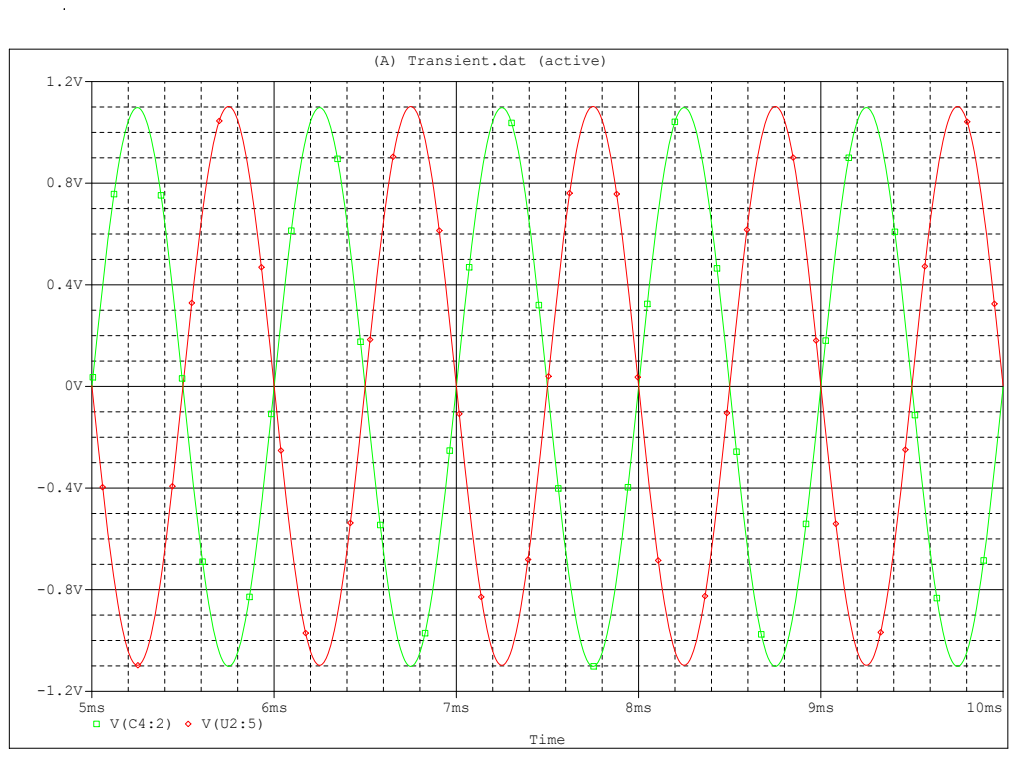
[picture p41: page 1]
Time
