afcaff/opamp-amp/(list of files, drawings)

Other design files:
sim/spice/TL072.OLB
sim/spice/tl072.opj
