afcaff/opamp-amp/kicad/audiopamp/audiopamp.kicad_pcb

## KiCad design kicad/audiopamp/audiopamp.kicad_pcb (2026-10-12)

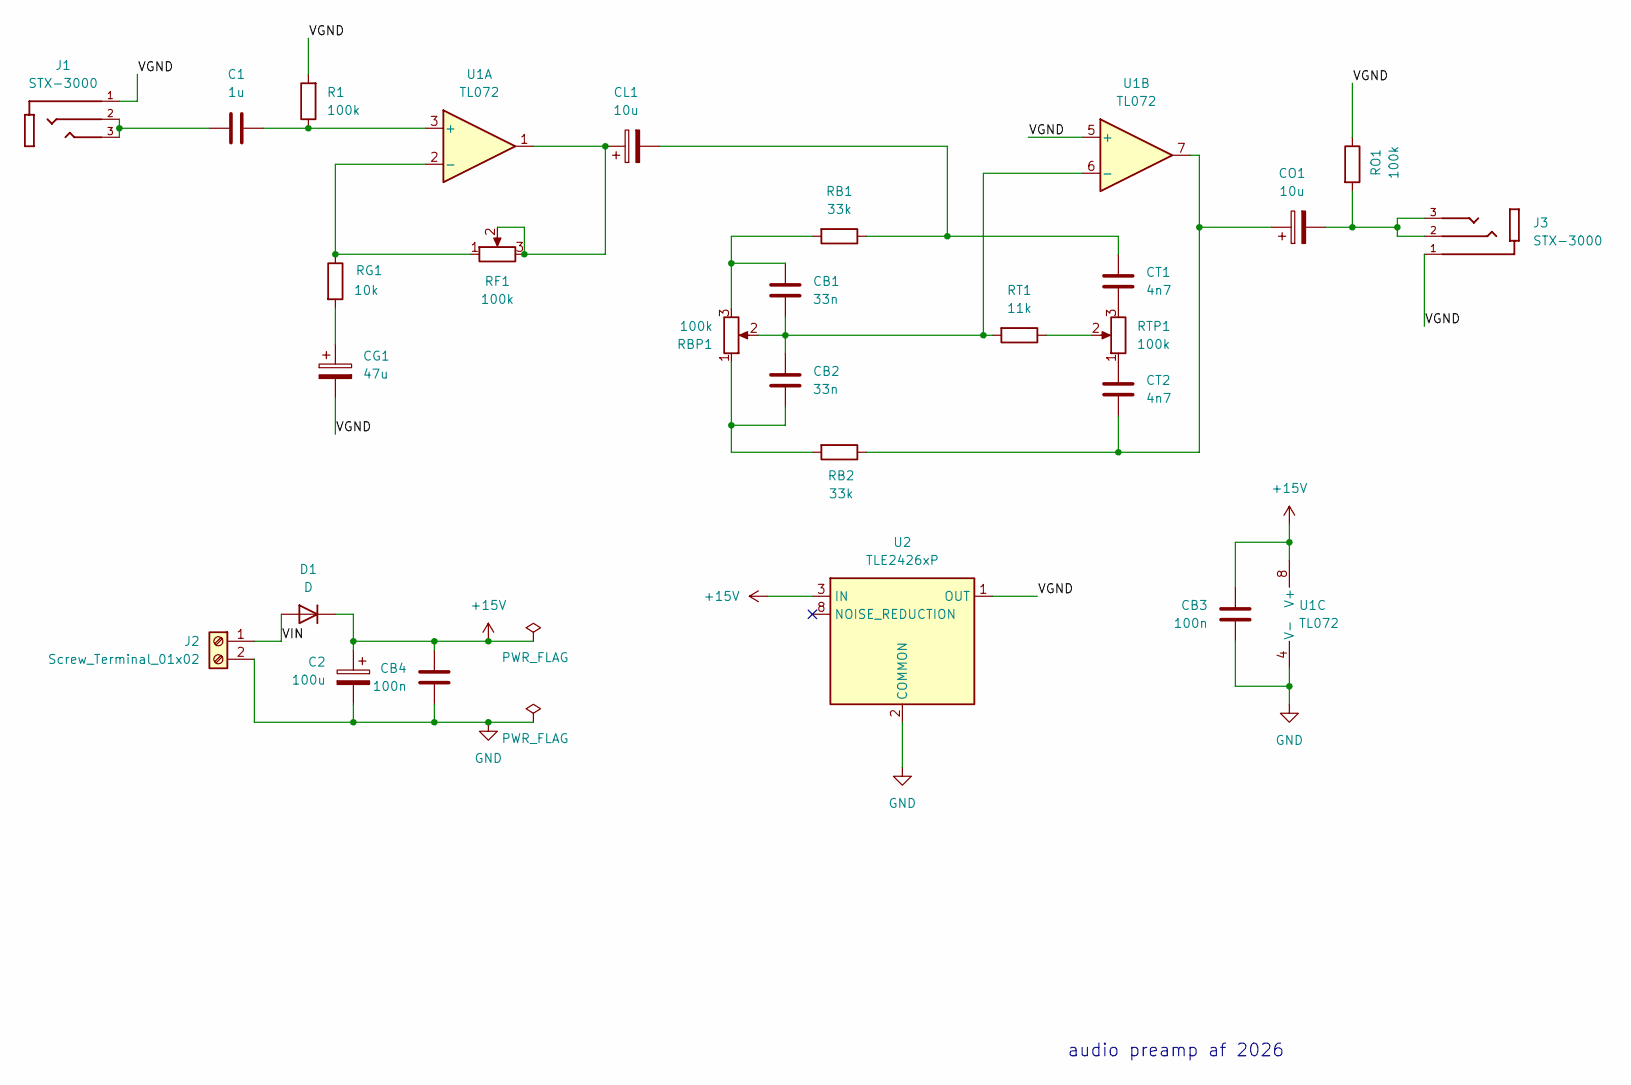
[picture p42: schematic audiopamp.kicad_sch]

Parts:
C1: 1u; C_Rect_L7.2mm_W5.5mm_P5.00mm_FKS2_FKP2_MKS2_MKP2
C2: 100u; CP_Radial_D5.0mm_P2.00mm
CB1, CB2: 33n; C_Rect_L7.2mm_W5.5mm_P5.00mm_FKS2_FKP2_MKS2_MKP2
CB3, CB4: 100n; C_Rect_L7.2mm_W5.5mm_P5.00mm_FKS2_FKP2_MKS2_MKP2
CG1: 47u; CP_Radial_D5.0mm_P2.00mm
CL1: 10u; CP_Radial_D5.0mm_P2.00mm
CO1: 10u; CP_Radial_D5.0mm_P2.00mm
CT1, CT2: 4n7; C_Rect_L7.2mm_W5.5mm_P5.00mm_FKS2_FKP2_MKS2_MKP2
D1: D; D_DO-41_SOD81_P10.16mm_Horizontal
J1, J3: STX-3000; KYCON_STX-3000
J2: Screw_Terminal_01x02; TerminalBlock_Phoenix_MKDS-1,5-2-5.08_1x02_P5.08mm_Horizont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
R1: 100k; R_Axial_DIN0207_L6.3mm_D2.5mm_P10.16mm_Horizontal
RB1, RB2: 33k; R_Axial_DIN0207_L6.3mm_D2.5mm_P10.16mm_Horizontal
RBP1: 100k; pdb12-M
RF1: 100k; pdb12-M
RG1: 10k; R_Axial_DIN0207_L6.3mm_D2.5mm_P10.16mm_Horizontal
RO1: 100k; R_Axial_DIN0207_L6.3mm_D2.5mm_P10.16mm_Horizontal
RT1: 11k; R_Axial_DIN0207_L6.3mm_D2.5mm_P10.16mm_Horizontal
RTP1: 100k; pdb12-M
U1: TL072; DIP-8_W7.62mm_Socket
U2: TLE2426xP; DIP-8_W7.62mm_Socket

Connections:
+15V: C2.1, CB3.2, CB4.2, D1.1 (K), U1.8 (V+), U2.3 (IN)
/VGND: CG1.2, J1.1, J3.1, R1.2, RO1.1, U1.5 (+), U2.1 (OUT)
/VIN: D1.2 (A), J2.1
GND: C2.2, CB3.1, CB4.1, J2.2, U1.4 (V-), U2.2 (COMMON)
unnamed: C1.1, J1.2, J1.3
unnamed: CB1.2, RB1.2, RBP1.3
unnamed: CB2.1, RB2.2, RBP1.1
unnamed: CG1.1, RG1.2
unnamed: CL1.1, RF1.2, RF1.3, U1.1
unnamed: CL1.2, CT1.2, RB1.1
unnamed: CO1.1, CT2.2, RB2.1, U1.7
unnamed: CO1.2, J3.2, J3.3, RO1.2
unnamed: CT1.1, RTP1.3
unnamed: CT2.1, RTP1.1
unnamed: RT1.1, RTP1.2
unnamed: C1.2, R1.1, U1.3 (+)
unnamed: RF1.1, RG1.1, U1.2 (-)
unnamed: CB1.1, CB2.2, RBP1.2, RT1.2, U1.6 (-)

Notes on the sheet:
audio preamp af 2026

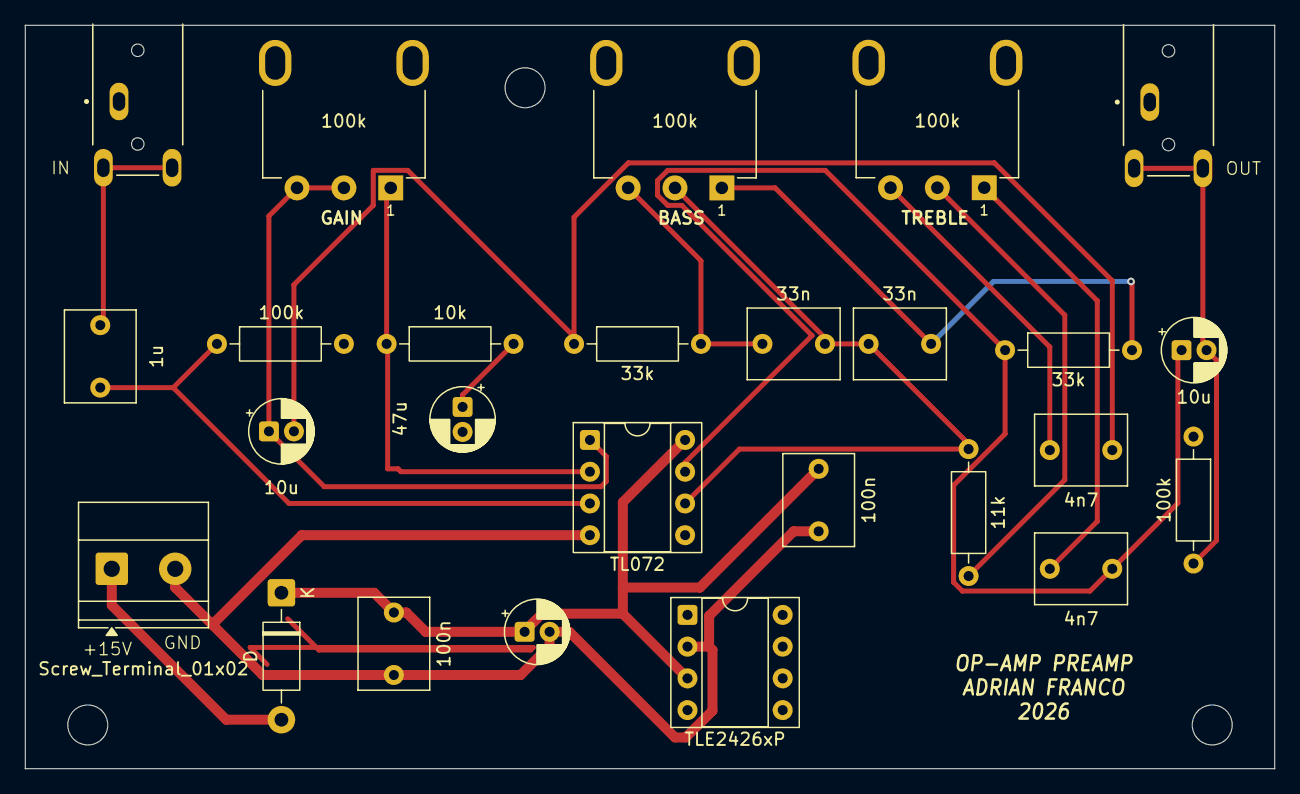
[picture p43: board audiopamp.kicad_pcb from above]

Board: 2 copper layers, 100.0 x 59.5 mm, 26 parts (0 on the bottom side), 18 nets.
