afcaff/opamp-amp/(commit log)

2026-10-01 non-inverting amplifier circuit using TL072, +- 7.5VDC
2026-10-01 gain circuit build and documented
2026-10-10 circuit breaboarded, first the gain stage then full circuit. Demo pictures and Videos included.
2026-10-10 Update README.md
    Clarified the issue with tone stage input sag and proposed a fix.
2026-10-12 PCB Design files. Version 1!
2026-10-12 pcb in readme
2026-10-25 pcb measures, pictures, and Demo added
2026-10-25 Update README with finished PCB image
