afcaff/opamp-amp/media/pcbbare.jpg

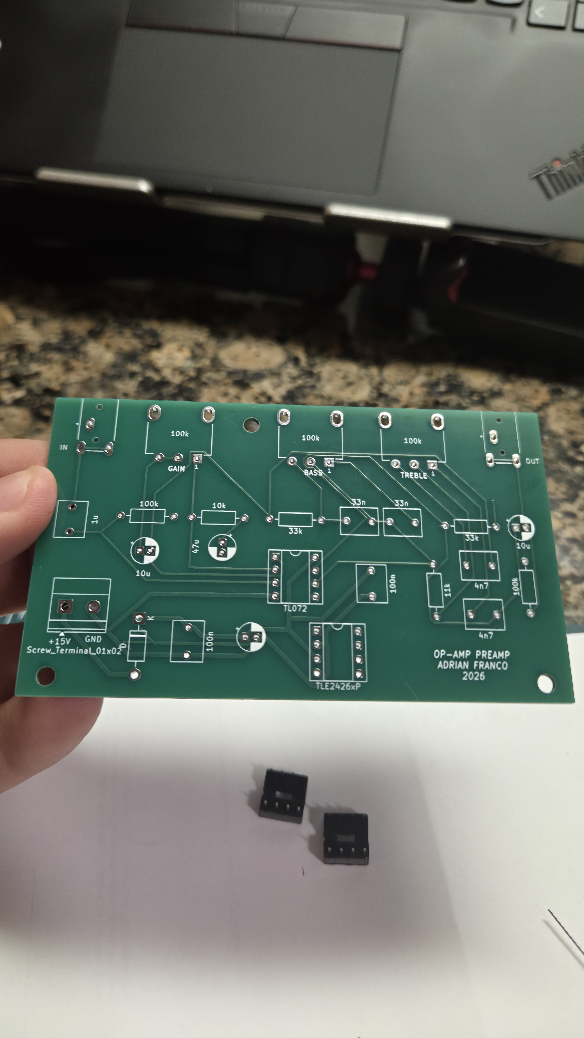
media/pcbbare.jpg
